Aleixgelabert/TFM/README.md

# TFM
Treball Final del Màster de Mecatrònica
