Aleixgelabert/TFM/SOFTWARE/LOGS/Log_ESP32_NO_OK.rtf

I (15945) ESP32: Rx_COM: SEQ_COM=0 RX_COM=504 LOST_COM=0 LOSS_COM=0.00%
I (15945) ESP32: vx: 0.0 vy: 0.0 BTN=0
I (15975) ESP32: Rx_COM: SEQ_COM=0 RX_COM=505 LOST_COM=0 LOSS_COM=0.00%
I (15975) ESP32: vx: 0.0 vy: 0.0 BTN=0
I (15995) ESP32: Rx_COM: SEQ_COM=0 RX_COM=506 LOST_COM=0 LOSS_COM=0.00%
I (15995) ESP32: vx: 0.0 vy: 0.0 BTN=0
I (16025) ESP32: Rx_COM: SEQ_COM=0 RX_COM=507 LOST_COM=0 LOSS_COM=0.00%
I (16025) ESP32: vx: 0.0 vy: 0.0 BTN=0
I (16055) ESP32: Rx_COM: SEQ_COM=0 RX_COM=508 LOST_COM=0 LOSS_COM=0.00%
I (16055) ESP32: vx: 0.0 vy: 0.0 BTN=0
I (16075) ESP32: Rx_COM: SEQ_COM=0 RX_COM=509 LOST_COM=0 LOSS_COM=0.00%
I (16075) ESP32: vx: 0.0 vy: 0.0 BTN=0
I (16115) ESP32: Rx_COM: SEQ_COM=0 RX_COM=510 LOST_COM=0 LOSS_COM=0.00%
I (16115) ESP32: vx: 0.0 vy: 0.0 BTN=0
I (16125) ESP32: Rx_COM: SEQ_COM=0 RX_COM=511 LOST_COM=0 LOSS_COM=0.00%
I (16125) ESP32: vx: 0.0 vy: 0.0 BTN=0
I (16145) ESP32: Rx_COM: SEQ_COM=0 RX_COM=512 LOST_COM=0 LOSS_COM=0.00%
I (16145) ESP32: vx: 0.0 vy: 0.0 BTN=0
I (16175) ESP32: Rx_COM: SEQ_COM=0 RX_COM=513 LOST_COM=0 LOSS_COM=0.00%
I (16175) ESP32: vx: 0.0 vy: 0.0 BTN=0
I (16205) ESP32: Rx_COM: SEQ_COM=0 RX_COM=514 LOST_COM=0 LOSS_COM=0.00%
I (16205) ESP32: vx: 0.0 vy: 0.0 BTN=0
I (16225) ESP32: Rx_COM: SEQ_COM=0 RX_COM=515 LOST_COM=0 LOSS_COM=0.00%
I (16225) ESP32: vx: 0.0 vy: 0.0 BTN=0
I (16245) ESP32: Rx_COM: SEQ_COM=0 RX_COM=516 LOST_COM=0 LOSS_COM=0.00%
I (16245) ESP32: vx: 0.0 vy: 0.0 BTN=0
I (16275) ESP32: Tx_ESP: SEQ_ESP=31 TX_ESP=31
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
I (27955) ESP32: vx: 90.0 vy: 90.0 BTN=0
I (27985) ESP32: Rx_COM: SEQ_COM=37166 RX_COM=995 LOST_COM=36841 LOSS_COM=97.37%
I (27985) ESP32: vx: 90.0 vy: 90.0 BTN=0
I (28005) ESP32: Rx_COM: SEQ_COM=37167 RX_COM=996 LOST_COM=36841 LOSS_COM=97.37%
I (28005) ESP32: vx: 90.0 vy: 90.0 BTN=0
I (28035) ESP32: Rx_COM: SEQ_COM=37168 RX_COM=997 LOST_COM=36841 LOSS_COM=97.37%
I (28035) ESP32: vx: 90.0 vy: 90.0 BTN=0
I (28055) ESP32: Rx_COM: SEQ_COM=37169 RX_COM=998 LOST_COM=36841 LOSS_COM=97.36%
I (28065) ESP32: vx: 90.0 vy: 90.0 BTN=0
I (28075) ESP32: Rx_COM: SEQ_COM=37170 RX_COM=999 LOST_COM=36841 LOSS_COM=97.36%
I (28075) ESP32: vx: 90.0 vy: 90.0 BTN=0
I (28105) ESP32: Rx_COM: SEQ_COM=37171 RX_COM=1000 LOST_COM=36841 LOSS_COM=97.36%
I (28105) ESP32: vx: 90.0 vy: 90.0 BTN=0
I (28145) ESP32: Rx_COM: SEQ_COM=37172 RX_COM=1001 LOST_COM=36841 LOSS_COM=97.35%
I (28145) ESP32: vx: 90.0 vy: 90.0 BTN=0
I (28155) ESP32: Rx_COM: SEQ_COM=37173 RX_COM=1002 LOST_COM=36841 LOSS_COM=97.35%
I (28155) ES--- Error: read failed: [Errno 6] Device not configured
--- Waiting for the device to reconnect..............
