Aleixgelabert/TFM/SOFTWARE/LOGS/LOG_ESP32_OK.rtf

I (5445) ESP32: Rx_COM: SEQ_COM=63598 RX_COM=108 LOST_COM=0 LOSS_COM=0.00%
I (5445) ESP32: vx: 180.0 vy: 90.0 BTN=1
I (5475) ESP32: Rx_COM: SEQ_COM=63599 RX_COM=109 LOST_COM=0 LOSS_COM=0.00%
I (5475) ESP32: vx: 180.0 vy: 90.0 BTN=1
I (5495) ESP32: Rx_COM: SEQ_COM=63600 RX_COM=110 LOST_COM=0 LOSS_COM=0.00%
I (5495) ESP32: vx: 180.0 vy: 90.0 BTN=1
I (5515) ESP32: Rx_COM: SEQ_COM=63601 RX_COM=111 LOST_COM=0 LOSS_COM=0.00%
I (5515) ESP32: vx: 180.0 vy: 90.0 BTN=1
I (5535) ESP32: Rx_COM: SEQ_COM=63602 RX_COM=112 LOST_COM=0 LOSS_COM=0.00%
I (5545) ESP32: vx: 180.0 vy: 90.0 BTN=1
I (5565) ESP32: Rx_COM: SEQ_COM=63603 RX_COM=113 LOST_COM=0 LOSS_COM=0.00%
I (5565) ESP32: vx: 180.0 vy: 90.0 BTN=1
I (5585) ESP32: Rx_COM: SEQ_COM=63604 RX_COM=114 LOST_COM=0 LOSS_COM=0.00%
I (5595) ESP32: vx: 180.0 vy: 90.0 BTN=1
I (5615) ESP32: Rx_COM: SEQ_COM=63605 RX_COM=115 LOST_COM=0 LOSS_COM=0.00%
I (5615) ESP32: vx: 180.0 vy: 90.0 BTN=1
I (5635) ESP32: Rx_COM: SEQ_COM=63606 RX_COM=116 LOST_COM=0 LOSS_COM=0.00%
I (5645) ESP32: vx: 180.0 vy: 90.0 BTN=1
I (5665) ESP32: Rx_COM: SEQ_COM=63607 RX_COM=117 LOST_COM=0 LOSS_COM=0.00%
I (5665) ESP32: vx: 180.0 vy: 90.0 BTN=1
I (5685) ESP32: Rx_COM: SEQ_COM=63608 RX_COM=118 LOST_COM=0 LOSS_COM=0.00%
I (5695) ESP32: vx: 180.0 vy: 90.0 BTN=1
I (5715) ESP32: Rx_COM: SEQ_COM=63609 RX_COM=119 LOST_COM=0 LOSS_COM=0.00%
I (5715) ESP32: vx: 180.0 vy: 90.0 BTN=1
I (5735) ESP32: Rx_COM: SEQ_COM=63610 RX_COM=120 LOST_COM=0 LOSS_COM=0.00%
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
