Aleixgelabert/TFM/HARDWARE/COMANDAMENT/MICROCONTROLADORS/ESP32/Micropython/PROVES MAIN/ILI9488b.py.html

Skip to content

## Navigation Menu

# Global navigation

Loading

© 2025 GitHub, Inc.

About (https://github.com/about) Blog (https://github.blog) Terms (https://docs.github.com/site-policy/github-terms/github-terms-of-service) Privacy (https://docs.github.com/site-policy/privacy-policies/github-privacy-statement) Security (https://github.com/security) Status (https://www.githubstatus.com/)

### Uh oh!

There was an error while loading. Please reload this page.

(https://github.com/)

Type / to search

# Search code, repositories, users, issues, pull requests...

Search

Clear

Search syntax tips (https://docs.github.com/search-github/github-code-search/understanding-github-code-search-syntax)

Give feedback

# Provide feedback

We read every piece of feedback, and take your input very seriously.

Include my email address so I can be contacted

Cancel Submit feedback

# Saved searches

## Use saved searches to filter your results more quickly

Name

Query

To see all available qualifiers, see our documentation (https://docs.github.com/search-github/github-code-search/understanding-github-code-search-syntax).

Cancel Create saved search

Chat with Copilot

Open Copilot…

Create new… Your issues Your pull requests

Notifications



### Uh oh!

There was an error while loading. Please reload this page.

Dismiss alert

Open in github.dev Open in a new github.dev tab Open in codespace

## FilesCollapse file tree

## Files

main

Add fileSearch this repository

t

/

# ILI9488b.py

Copy path

BlameMore file actions

BlameMore file actions

## Latest commit

## History

History

217 lines (177 loc) · 7.99 KB

/

# ILI9488b.py

Top

## File metadata and controls

- Code
- Blame

217 lines (177 loc) · 7.99 KB

Raw (https://github.com/L3pu5/ILI9488_micropython/raw/refs/heads/main/ILI9488b.py)

Copy raw file

Download raw file

(https://github.dev/) (https://github.dev/)

Fork this repository and edit the file

More edit options

Open symbols panel

Edit and raw actions

1

2

3

4

5

6

7

8

9

10

11

12

13

14

15

16

17

18

19

20

21

22

23

24

25

26

27

28

29

30

31

32

33

34

35

36

37

38

39

40

41

42

43

44

45

46

47

48

49

50

51

52

53

54

55

56

57

58

59

60

61

62

63

64

65

66

67

68

69

70

71

72

73

74

75

76

77

78

79

80

81

82

83

84

85

86

87

88

89

90

91

92

93

94

95

96

97

98

99

100

101

102

103

104

105

106

107

108

109

110

111

112

113

114

115

116

117

118

119

120

121

122

123

124

125

126

127

128

129

130

131

132

133

134

135

136

137

138

139

140

141

142

143

144

145

146

147

148

149

150

151

152

153

154

155

156

157

158

159

160

161

162

163

164

165

166

167

168

169

170

171

172

173

174

175

176

177

178

179

180

181

182

183

184

185

186

187

188

189

190

191

192

193

194

195

196

197

198

199

200

201

202

203

204

205

206

207

208

209

210

211

212

213

214

215

216

# ILI4988b.

# By L3pu5, L3pu5_Hare

# A simple Python wrapper for the ILI4988 driver bound to the SPI interface IM[2:0] 101 for chipsets such as

# those ubuqituous ones on Aliexpress.

from c565_chunk.c565_chunk import c565_chunk_image, c565_chunk

from bnuuyDrivers_micropython.RECTANGLE import RECTANGLE

from time import sleep

from math import floor

import ustruct

PICO_EXPERIMENTAL_MAX_BUFFER = 60_000 #Bytes, give/take memory. (42512 with earlier verison of this build)

# Ihave gotten this to 60_000?

#565 RGBcolour 2 byte datastructure

def color565(r,g,b):

return (r & 0xf8) << 8 | (g & 0xfc) << 3 | b >> 3

class Display():

#Initialised Register values are defined on 13.1 pg. 306

# Mostly : Sleep IN, Display OFF, Idle OFF, All Pixels OFF, Col_End 0x013F Row_End 0x01DF

# : Color_pixel_format 18Bit/Pix

# Command constants from ILI9488 datasheet (Limited)

# * Can be used in short Packet (no param)

# ** Can be used in short Packet (1 param)

# WRITE - NO PARAM Note Ref

NO_OP = const(0x00) # No Operation * 5.2.1

SOFT_RESET = const(0x01) # Software Reset * 5.2.2

SLEEP_IN = const(0x10) # Enter Sleep * 5.2.12

SLEEP_OUT = const(0x11) # Leave Sleep * 5.2.13

## ??

PIXELS_ALL_OFF = const(0x22) # Turn all pixels off 5.2.18

PIXELS_ALL_ON = const(0x23) # Turn all pixels on 5.2.19

## CONFIGURATION?

PIXELS_FORMAT = const(0x3A) # Colour format 5.2.34 DBI[2:0], DPI[2:0] -> 101 for 565 --> b'01010101'

CONFIG_BUFFER = const(0x36) # Buffer configuration 5.2.30

DISPLAY_FUNC = const(0xB6) # Display Op Mode 5.3.7

## OPERATIONAL MODES

MODE_PARTIAL = const(0x12) # Enter Partial * 5.2.14 (Described in 0x30, )

MODE_NORMAL = const(0x13) # Enter Normal * 5.2.15 (Disables Scroll/partial mode)

## DISPLAY MODES

DISPLAY_OFF = const(0x28) # Turn Display off * 5.2.20 (Screen still lit, memory not drawn)

DISPLAY_ON = const(0x29) # Turn Display on * 5.2.21

## IDLE MODES

IDLE_ON = const(0x39) # Enter Idle * 5.2.33 (Nukes colour density to save power)

IDLE_OFF = const(0x38) # Leave Idle * 5.2.32 (Full colour density)

ADDR_SET_COL = const(0x2A) # Set Col *

ADDR_SET_ROW = const(0x2B) # Set Row/Page *

WRITE_MEM = const(0x2C) # Write Memory * 5.2.24

FRAME_RATE = const(0xB1) # 5.3.2

CABC_9 = const(0xCF) # 5.3.26

#CABC_9 is the only needed CABC control.

def __init__(self, spi, cs, dc, rst, width, height):

#CS, DC are of type PIN()

#CS pin means the chip is selected and data is going to be sent over the serial bus

#DC means data/command -> if low, command, if high parameter.

self.spi = spi

self.cs = cs

self.dc = dc

self.reset = rst

self.width = width

self.height = height

self.buffer = b""

#Set default pin values

self.cs.init(self.cs.OUT, value=1)

self.dc.init(self.dc.OUT, value=0)

self.reset.init(self.reset.OUT, value=1)

cs.value(1)

dc.value(0)

rst.value(1)

self.minimum_board_init()

self.minimum_configuration()

#self.build_buffer()

self.clear()

def build_buffer(self):

#Do some controls here to see if we can save memory, or afford the buffer

self.buffer = color565(0,0,0).to_bytes(2, "big") * self.width * self.height

def minimum_board_init(self):

#Send the reset command to the display screen

self.full_reset()

sleep(.2)

#Awake

self.write_command(self.SLEEP_OUT)

sleep(.1)

#???

self.write_command(self.CABC_9, 0x10)

#Screen ON

self.write_command(self.DISPLAY_ON)

#CABC_9 is the ONLY required field.

def minimum_configuration(self):

#Set Pixel format

self.write_command(self.PIXELS_FORMAT, int(b'01010101', 2))

#Orientation

self.write_command(self.CONFIG_BUFFER, int(b"01101000",2))

def clear(self):

self.write_buffer(0,0, self.width, self.height, self.buffer)

def full_reset(self):

#Reset the buffers on the display board

self.write_command(self.SOFT_RESET)

#ALlow device to do the reset

sleep(.2)

def reset_display(self):

self.reset(1)

sleep(0.05)

self.reset(0)

sleep(0.05)

#Drawing Functions

# Draw Buffer

def write_buffer(self, rect, buffer):

self.write_buffer(rect.x, rect.y, rect.width, rect.height, buffer)

def write_buffer(self, x, y, width, height, buffer):

self.write_command(self.ADDR_SET_ROW, *ustruct.pack(">HH", x, x+width-1))

self.write_command(self.ADDR_SET_COL, *ustruct.pack(">HH", y, y+height-1))

self.write_command(self.WRITE_MEM)

self.write_data(buffer)

# Draw c565 Chunk

def draw_c565_chunk(self, chunk: c565_chunk):

self.write_buffer(chunk.get_image_x(), chunk.get_image_y(), chunk.width, chunk.height, chunk.buffer)

print(chunk)

# Draw Buffer -> Draw c565 Image

def draw_c565_image(self, path):

image = c565_chunk_image()

image.read_from_image_file(path)

image.iterate_with_c565chunks( lambda chunk: self.draw_c565_chunk(chunk))

#Dispose of the image

del image

# Draw Pixel

def draw_pixel(self, x, y, colour):

self.write_buffer(x, y, 0, 0, colour.to_bytes(2, 'big'))

# Draw Rect

def fill_rectangle(self, rect, color):

buffer = color.to_bytes(2, "big") * rect.width * rect.height

self.write_buffer(rect.x, rect.y, rect.width, rect.height, buffer)

#Drawing Troubleshooting functions

def test_single_range(self, cmd, min, max, step, deltaTime, color=0x00):

for i in range(min, max, step):

self.write_command(cmd, i)

self.draw_horizontal_range_bar(0, self.height-20, self.width, 20,(i-min)/max, color)

sleep(deltaTime)

self.write_command(cmd, min)

def test_single_range_custom_bar(self, cmd, min, max, step, deltaTime, custom_bar, color=0x00):

if(custom_bar.width > custom_bar.height):

for i in range(min, max, step):

self.write_command(cmd, i)

self.draw_horizontal_range_bar(custom_bar,(i-min)/(max), color)

sleep(deltaTime)

else:

for i in range(min, max, step):

self.write_command(cmd, i)

self.draw_vertical_range_bar(custom_bar, (i-min)/(max) ,color)

sleep(deltaTime)

self.write_command(cmd, min)

#A horizontal bar starting at x,y growing to x+width, y+height,

def draw_horizontal_range_bar(self, rect, progress, color=0x00):

trueWidth = floor((rect.width)*progress)

intermediate = RECTANGLE.from_dimensions(rect.x,rect.y,trueWidth, rect.height)

self.fill_rectangle(intermediate, color)

#A vertical bar starting at x,y growing to x+width, y+height

def draw_vertical_range_bar(self, rect, progress, color=0x00):

trueHeight = floor((rect.height)*progress)

intermediate = RECTANGLE.from_dimensions(rect.x,rect.y,rect.width, trueHeight)

print(intermediate)

self.fill_rectangle(intermediate, color)

# IO

# Data Functions

def write_data(self, buffer):

self.dc(1)

self.cs(0)

self.spi.write(buffer)

self.cs(1)

def write_command(self, cmd, *opt_args):

# Set DC = 0 for Data, set CS to 0

self.dc(0)

self.cs(0)

self.spi.write(bytearray([cmd]))

self.cs(1)

if len(opt_args) > 0:

self.write_data(bytearray(opt_args))

## Footer

(https://github.com) © 2025 GitHub, Inc.

You can’t perform that action at this time.
