Aleixgelabert/TFM/DOCS/aft-view-of-SKORPIOS-by-Nautors-Swan-665x443.jpg

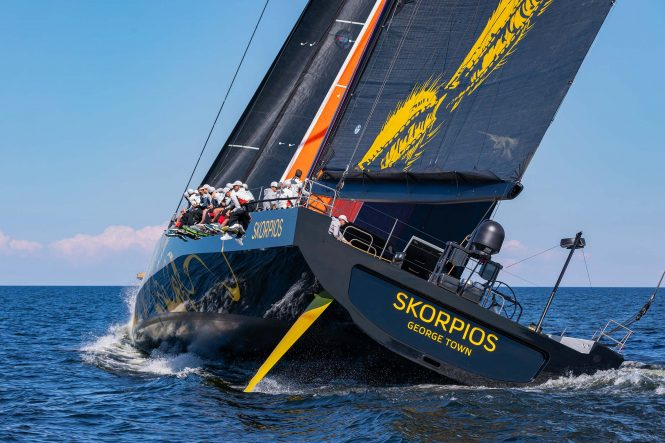
DOCS/aft-view-of-SKORPIOS-by-Nautors-Swan-665x443.jpg
