Aleixgelabert/TFM/DOCS/IMATGES/BATERIA_RTC.png

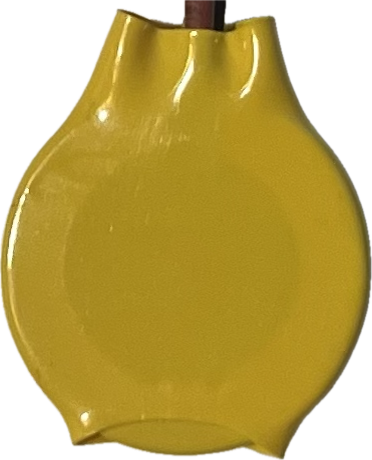
DOCS/IMATGES/BATERIA_RTC.png
