Aleixgelabert/TFM/DOCS/IMATGES/BOTONERA_CARIBONI.jpg

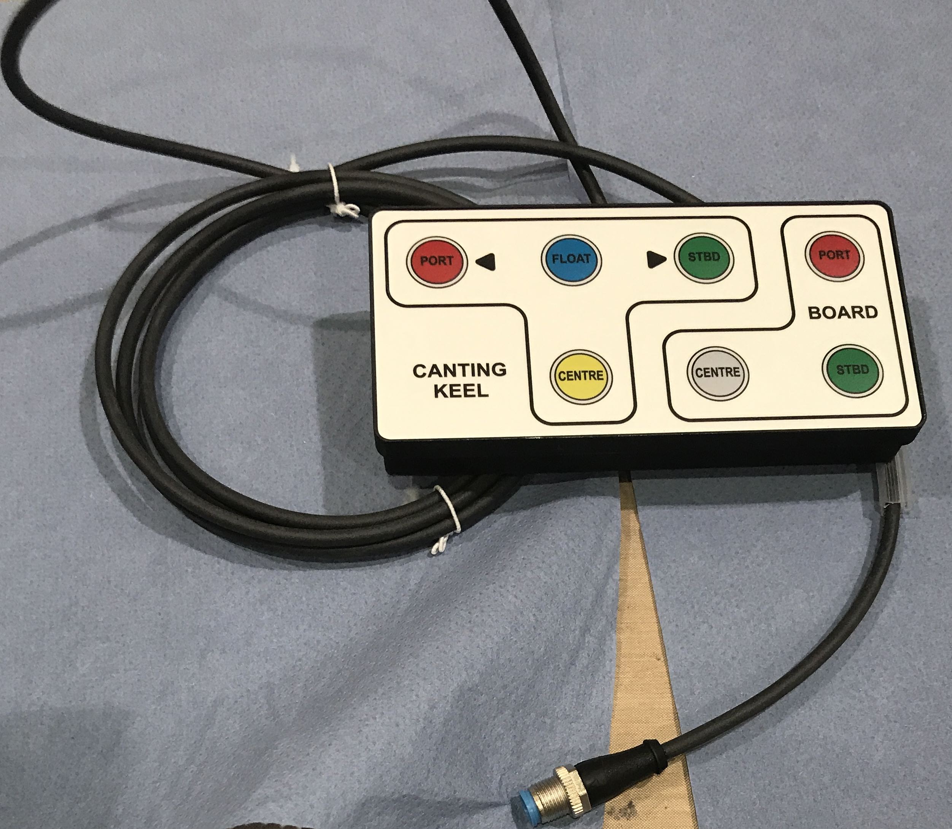
DOCS/IMATGES/BOTONERA_CARIBONI.jpg
