Aleixgelabert/TFM/DOCS/IMATGES/Diode.png

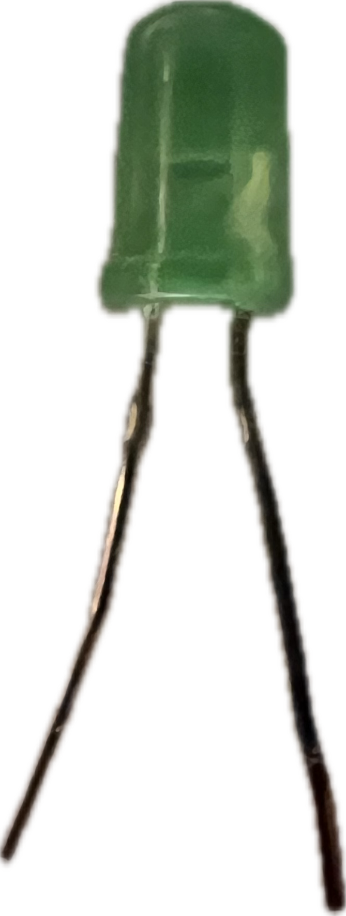
DOCS/IMATGES/Diode.png
