Aleixgelabert/TFM/DOCS/IMATGES/Diode_RGB.png

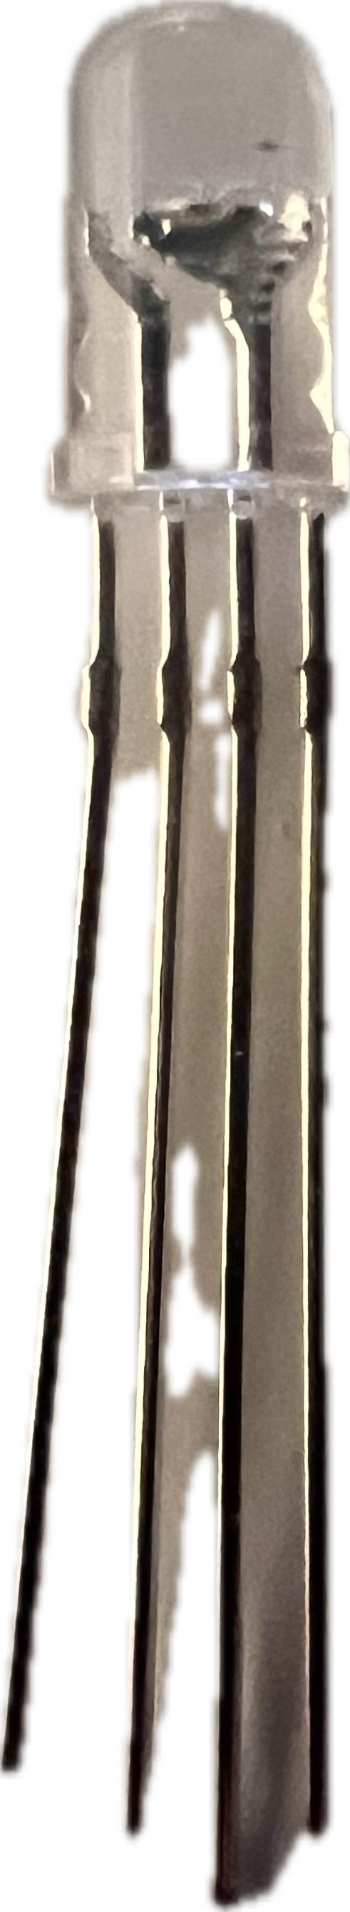
DOCS/IMATGES/Diode_RGB.png
