Aleixgelabert/TFM/DOCS/IMATGES/Esquema_1.jpg

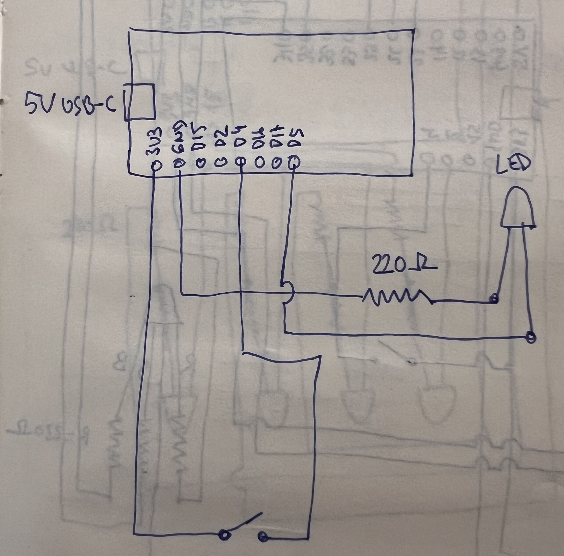
DOCS/IMATGES/Esquema_1.jpg
