Aleixgelabert/TFM/DOCS/IMATGES/Esquema_2.jpg

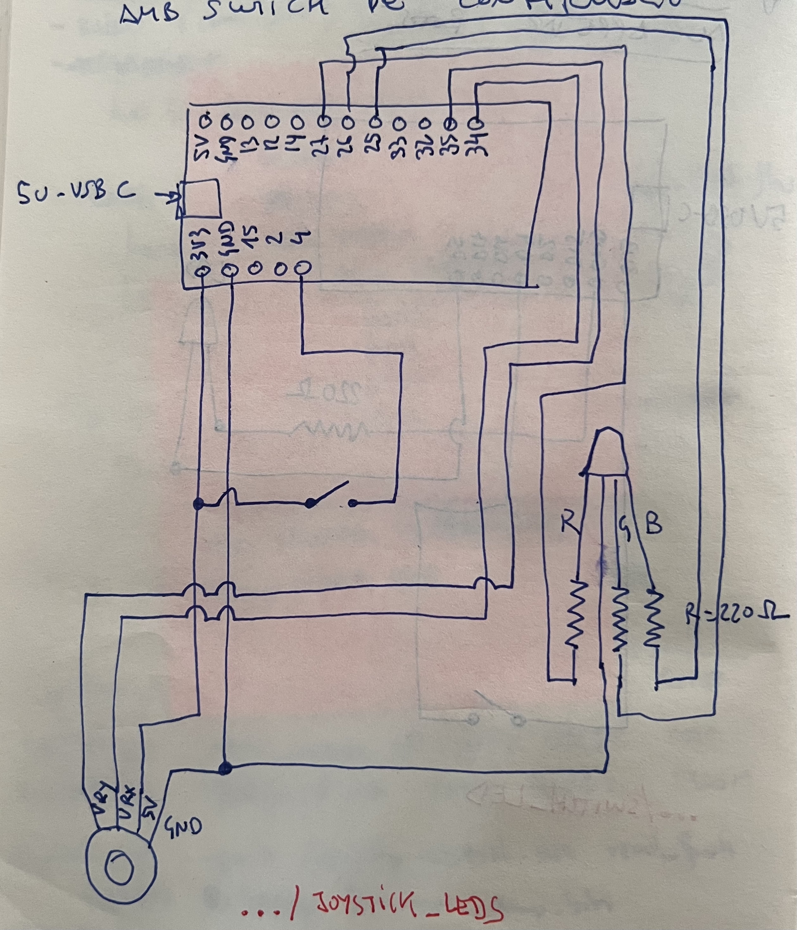
DOCS/IMATGES/Esquema_2.jpg
