Aleixgelabert/TFM/DOCS/IMATGES/Esquema_3.jpg

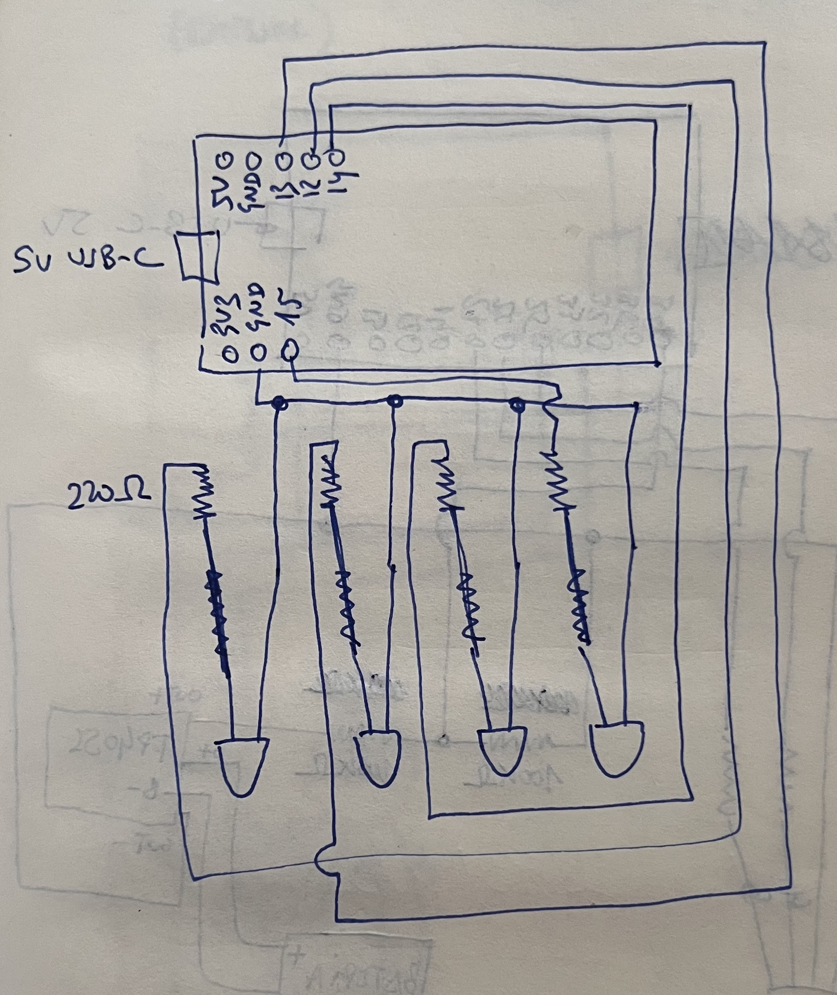
DOCS/IMATGES/Esquema_3.jpg
