Aleixgelabert/TFM/DOCS/IMATGES/Esquema_4.jpg

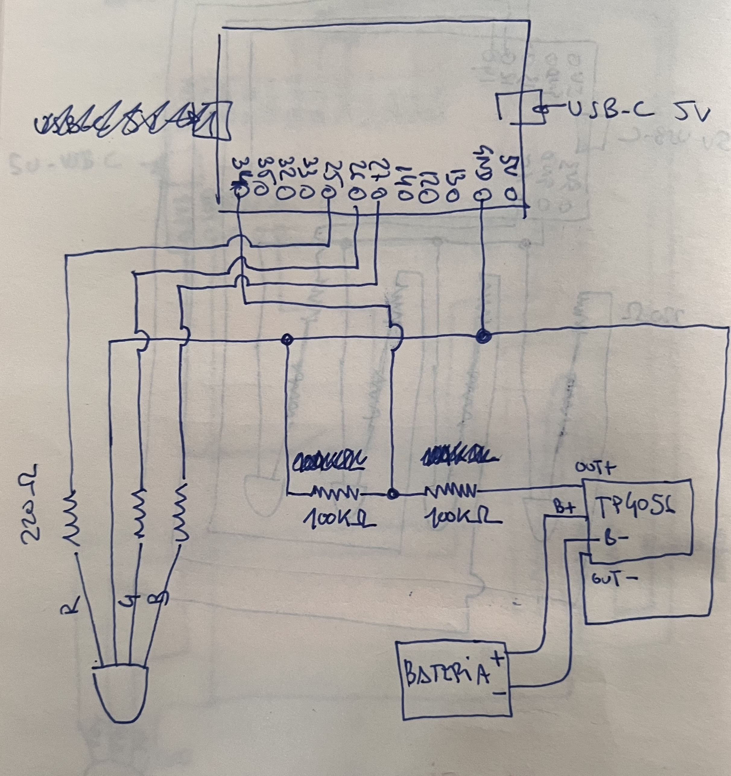
DOCS/IMATGES/Esquema_4.jpg
