Aleixgelabert/TFM/DOCS/IMATGES/Esquema_5.jpg

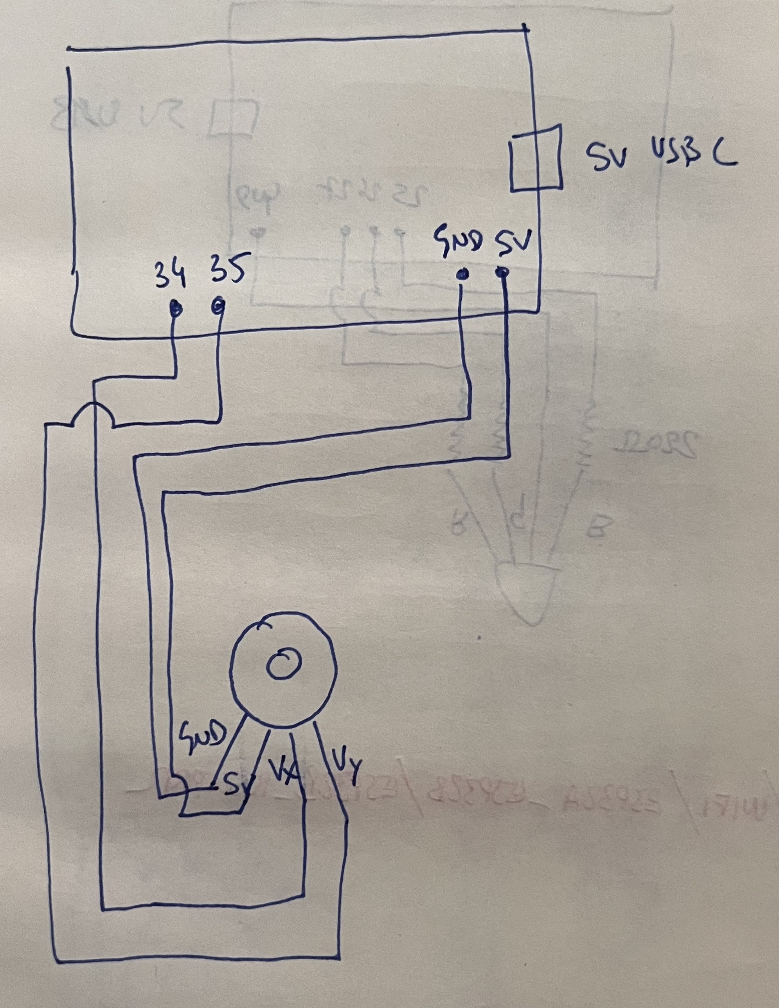
DOCS/IMATGES/Esquema_5.jpg
