Aleixgelabert/TFM/DOCS/IMATGES/Esquema_6.jpg

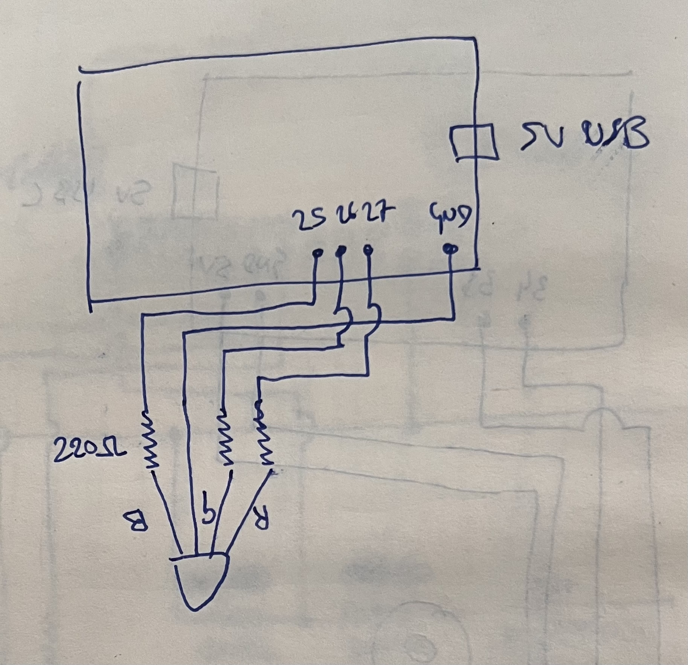
DOCS/IMATGES/Esquema_6.jpg
