Aleixgelabert/TFM/DOCS/IMATGES/Esquema_7.jpg

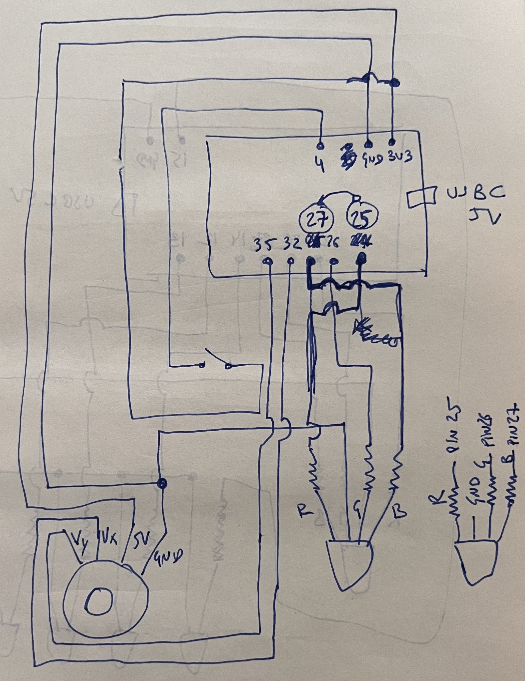
DOCS/IMATGES/Esquema_7.jpg
