Aleixgelabert/TFM/DOCS/IMATGES/Esquema_8.jpg

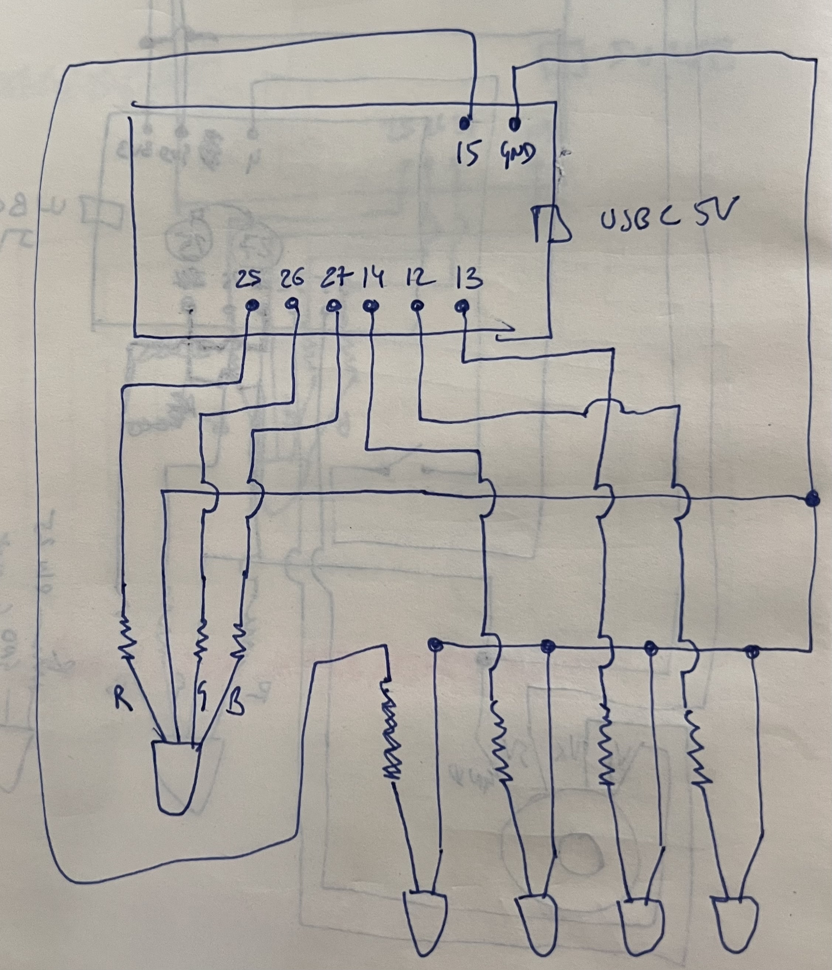
DOCS/IMATGES/Esquema_8.jpg
