Aleixgelabert/TFM/DOCS/IMATGES/Esquema_9.jpg

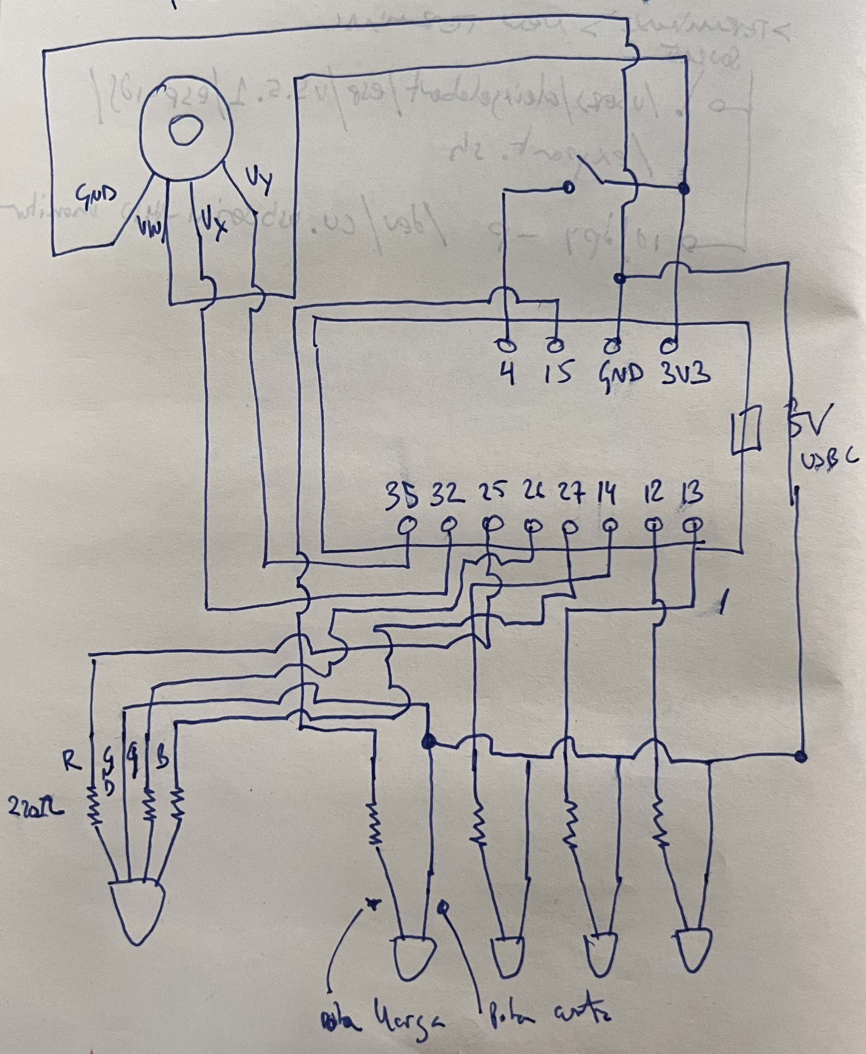
DOCS/IMATGES/Esquema_9.jpg
