Aleixgelabert/TFM/DOCS/IMATGES/Esquema_10.jpg

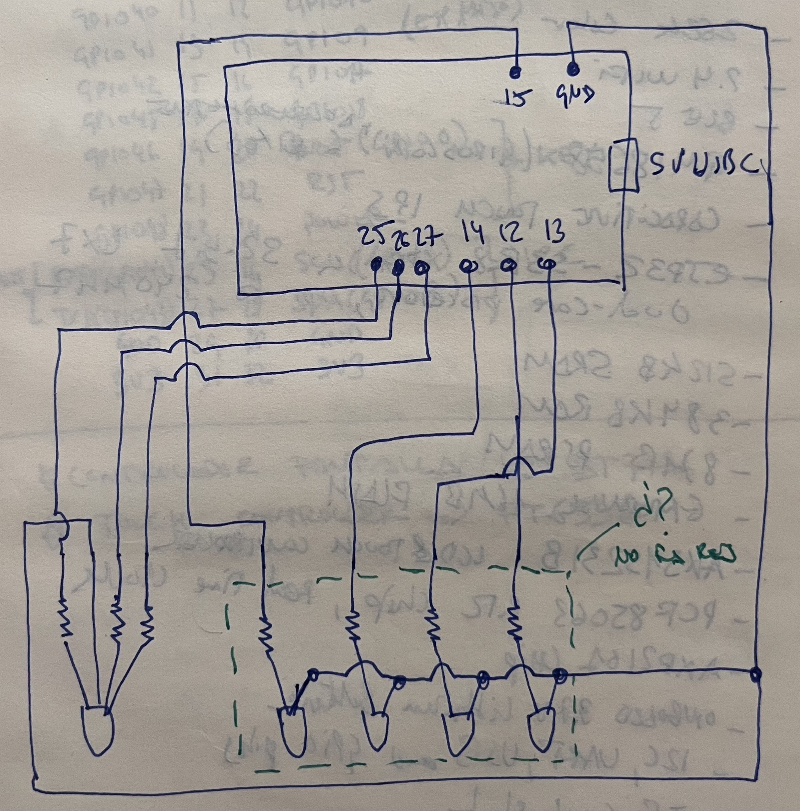
DOCS/IMATGES/Esquema_10.jpg
