Aleixgelabert/TFM/DOCS/IMATGES/Esquema_11.jpg

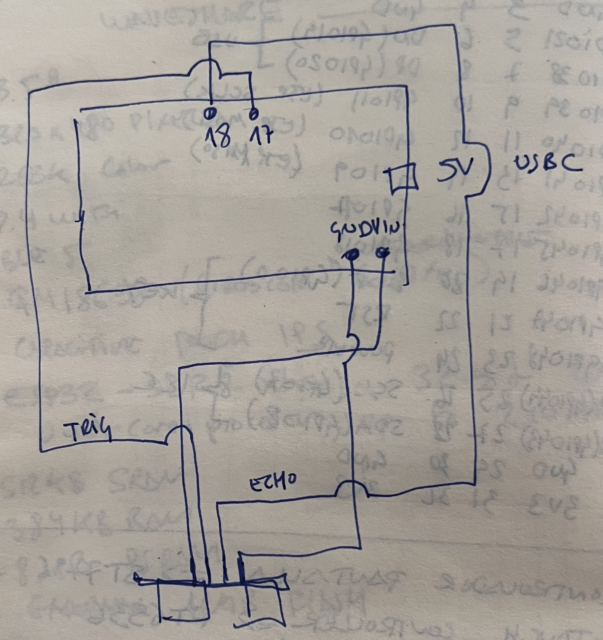
DOCS/IMATGES/Esquema_11.jpg
