Aleixgelabert/TFM/DOCS/IMATGES/Esquema_12.jpg

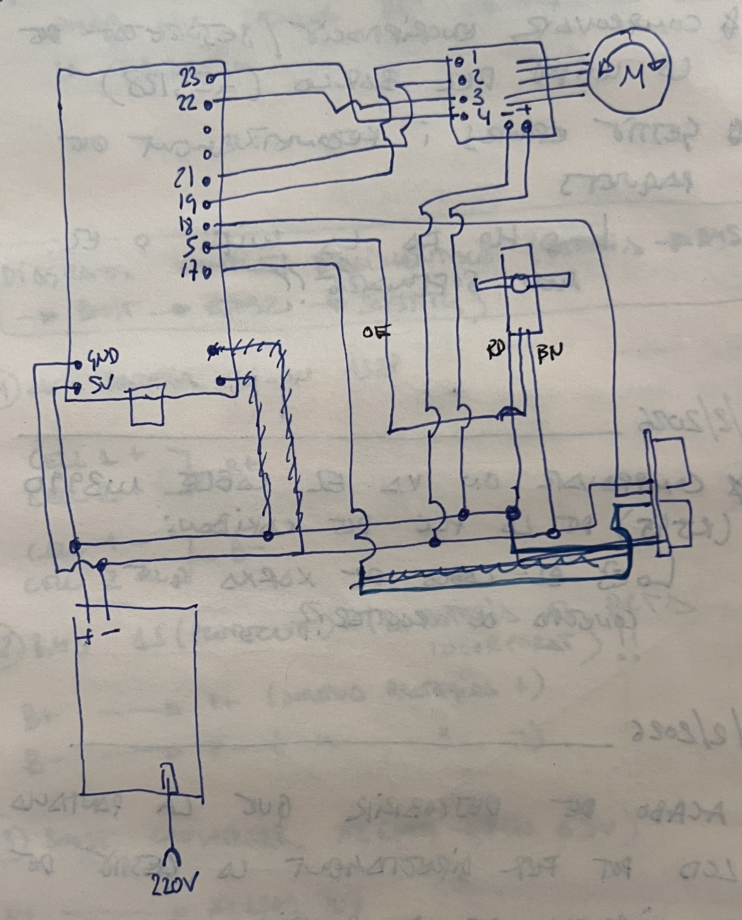
DOCS/IMATGES/Esquema_12.jpg
