Aleixgelabert/TFM/DOCS/IMATGES/JOYSTICK_SERIES_68B.png

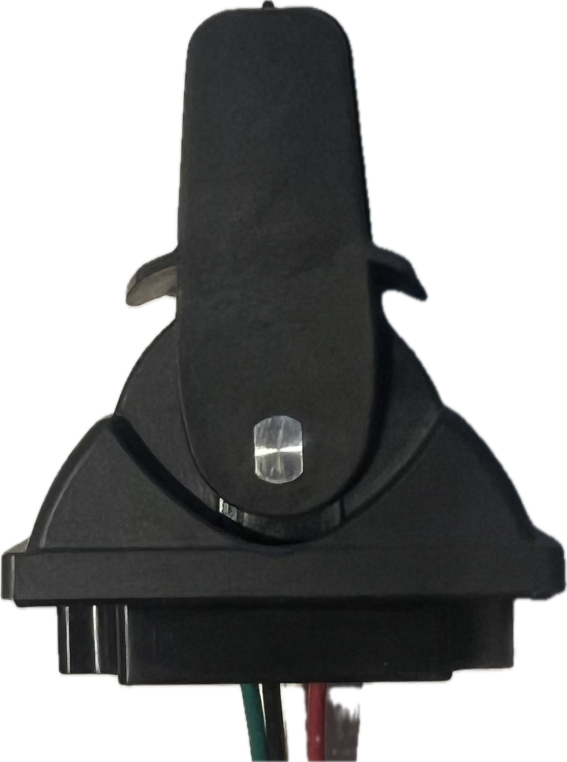
DOCS/IMATGES/JOYSTICK_SERIES_68B.png
