Aleixgelabert/TFM/DOCS/IMATGES/Model_Simulacio.png

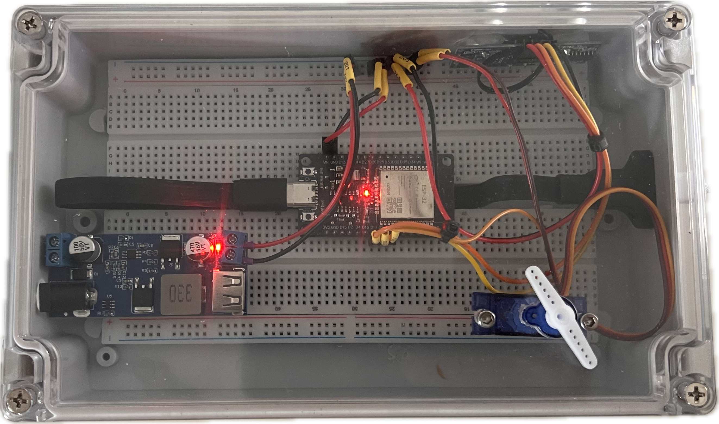
DOCS/IMATGES/Model_Simulacio.png
