Aleixgelabert/TFM/DOCS/IMATGES/Resistència.jpg

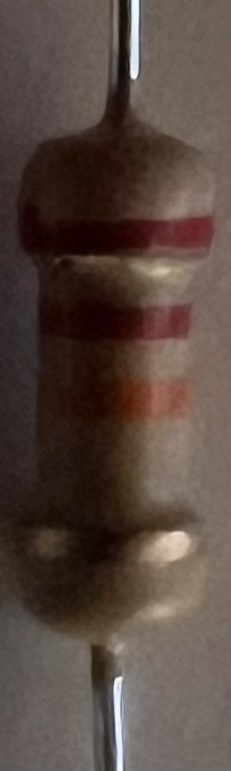
DOCS/IMATGES/Resistència.jpg
