Aleixgelabert/TFM/DOCS/IMATGES/Stepper.png

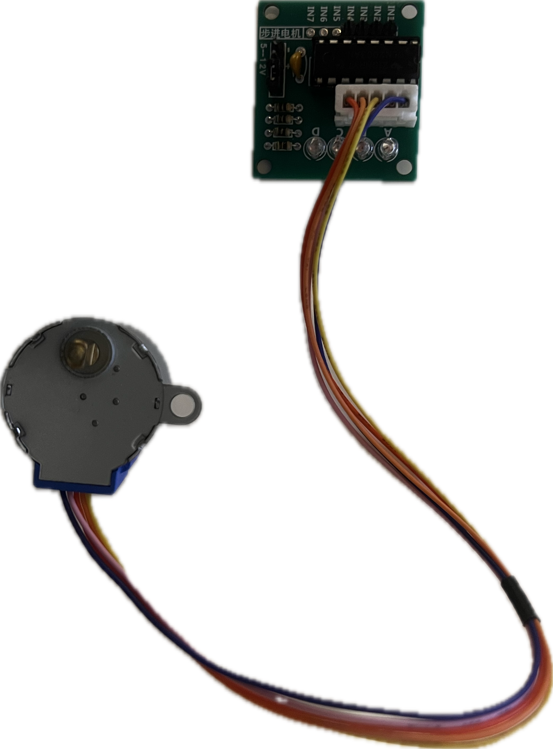
DOCS/IMATGES/Stepper.png
