Aleixgelabert/TFM/DOCS/IMATGES/STEPPER_MOTOR.png

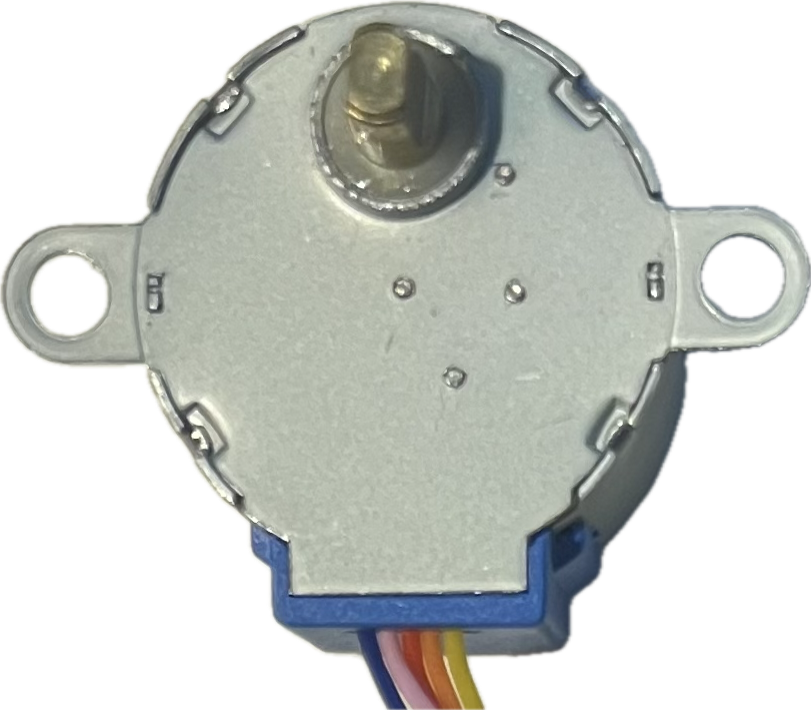
DOCS/IMATGES/STEPPER_MOTOR.png
