Aleixgelabert/TFM/DOCS/IMATGES/TP4056.png

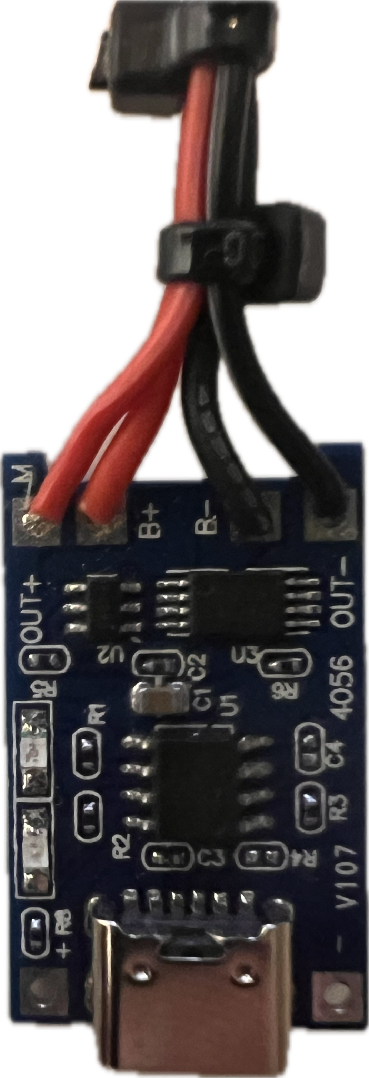
DOCS/IMATGES/TP4056.png
