Aleixgelabert/TFM/HARDWARE/EXISTENT SKORPIOS/SOFTWARE/PLC Twincat/BIN/VISU_BACKGROUND.bmp

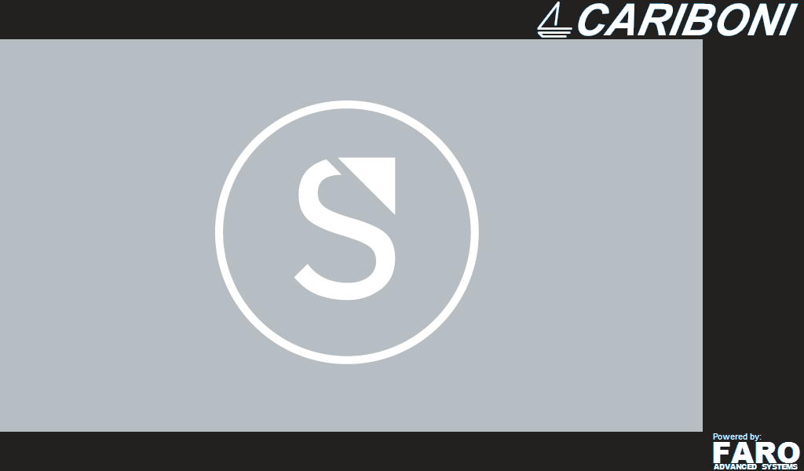
HARDWARE/EXISTENT SKORPIOS/SOFTWARE/PLC Twincat/BIN/VISU_BACKGROUND.bmp
