Aleixgelabert/TFM/HARDWARE/EXISTENT SKORPIOS/SOFTWARE/PLC Twincat/BIN/VISU_BOARD.bmp

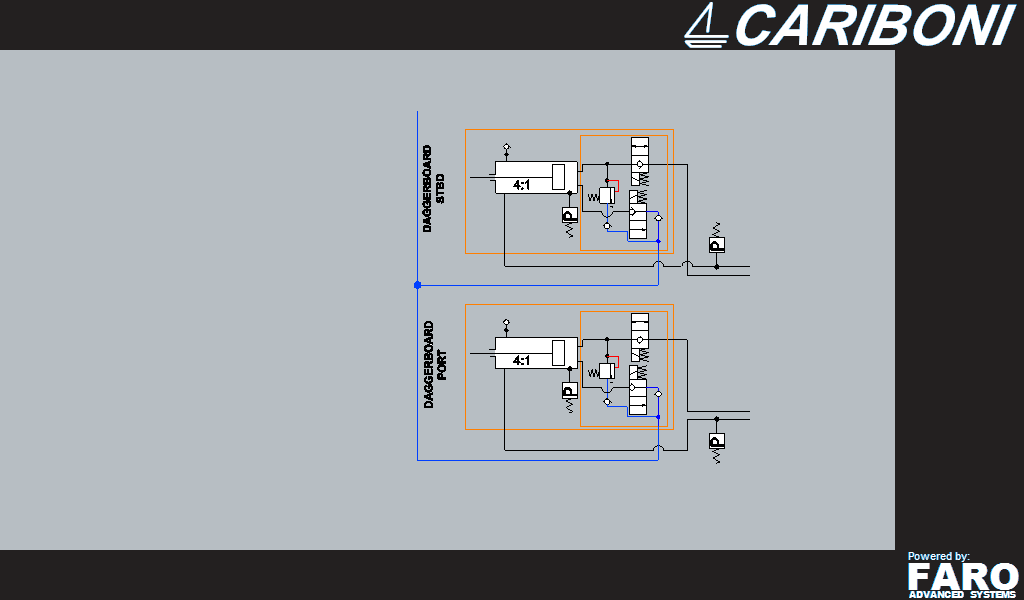
HARDWARE/EXISTENT SKORPIOS/SOFTWARE/PLC Twincat/BIN/VISU_BOARD.bmp
