Aleixgelabert/TFM/HARDWARE/EXISTENT SKORPIOS/SOFTWARE/PLC Twincat/BIN/VISU_HOME.bmp

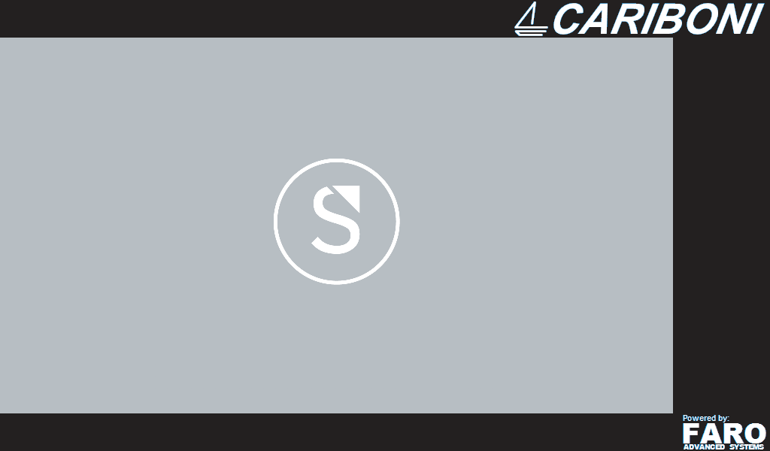
HARDWARE/EXISTENT SKORPIOS/SOFTWARE/PLC Twincat/BIN/VISU_HOME.bmp
