Aleixgelabert/TFM/HARDWARE/EXISTENT SKORPIOS/SOFTWARE/PLC Twincat/BIN/VISU_KEEL.bmp

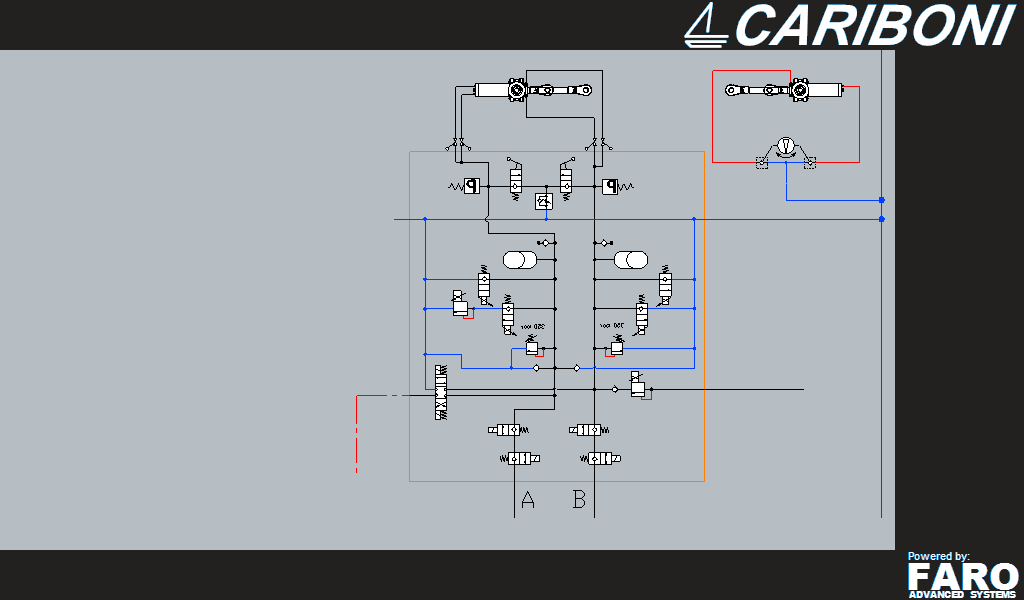
HARDWARE/EXISTENT SKORPIOS/SOFTWARE/PLC Twincat/BIN/VISU_KEEL.bmp
