Aleixgelabert/TFM/HARDWARE/EXISTENT SKORPIOS/SOFTWARE/PLC Twincat/BIN/VISU_PUMPS.bmp

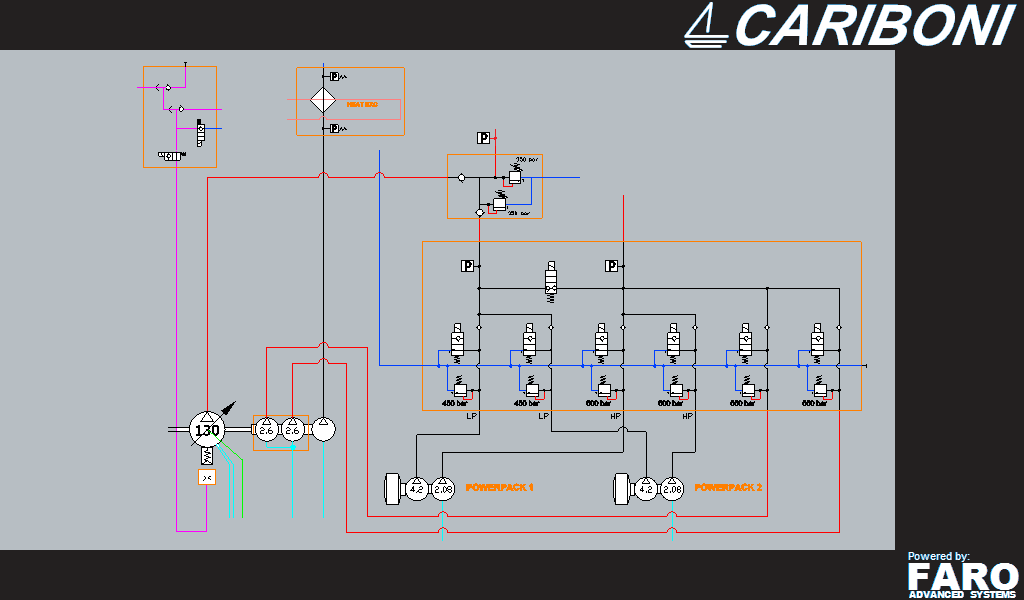
HARDWARE/EXISTENT SKORPIOS/SOFTWARE/PLC Twincat/BIN/VISU_PUMPS.bmp
