Aleixgelabert/TFM/HARDWARE/EXISTENT SKORPIOS/SOFTWARE/PLC Twincat/screensaver.bmp

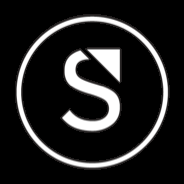
HARDWARE/EXISTENT SKORPIOS/SOFTWARE/PLC Twincat/screensaver.bmp
