Aleixgelabert/TFM/HARDWARE/EXISTENT SKORPIOS/SOFTWARE/PLC Twincat/unnamed.png

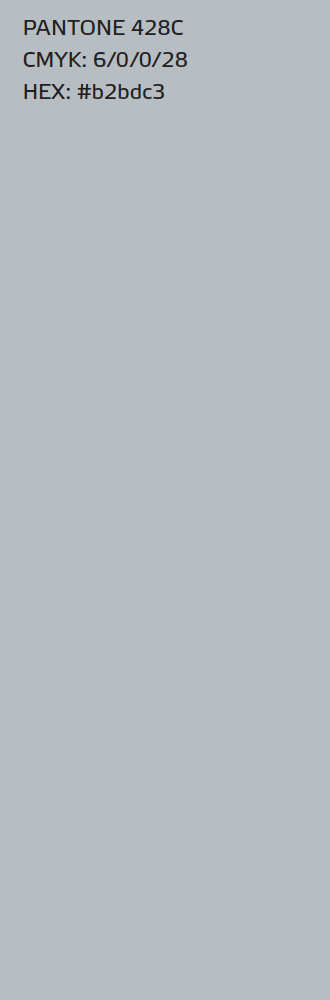
HARDWARE/EXISTENT SKORPIOS/SOFTWARE/PLC Twincat/unnamed.png
