Aleixgelabert/TFM/HARDWARE/JOYSTICKS/GRAYHILL_SERIES_68B/68b-drawing-01.jpg

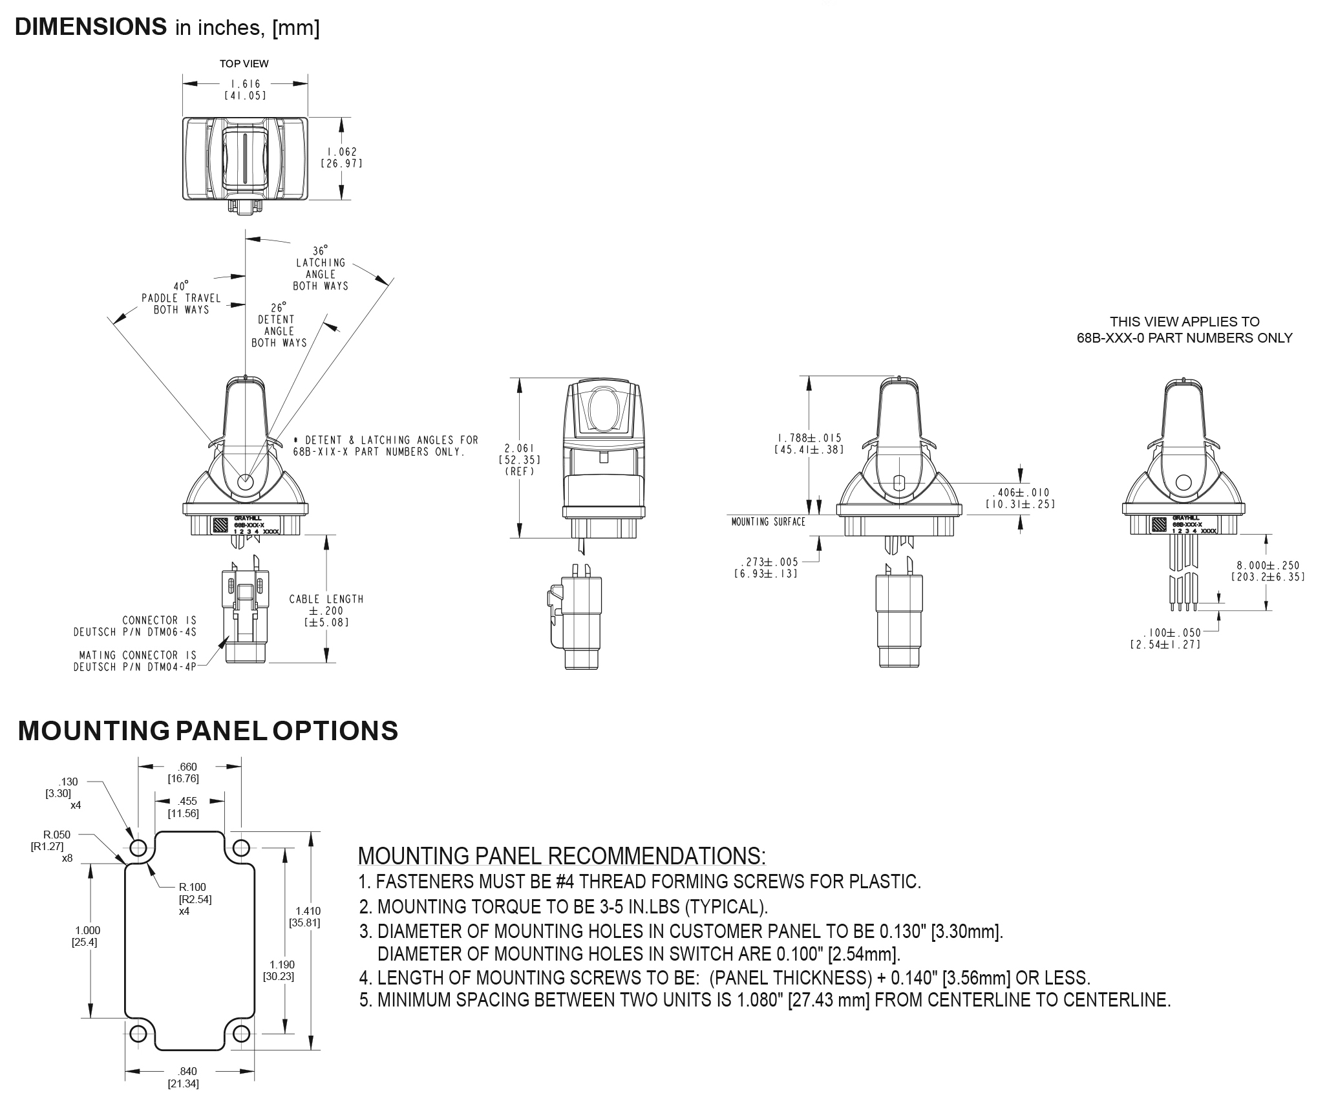
HARDWARE/JOYSTICKS/GRAYHILL_SERIES_68B/68b-drawing-01.jpg
