Aleixgelabert/TFM/HARDWARE/JOYSTICKS/GRAYHILL_SERIES_68B/68b-drawing-02.jpg

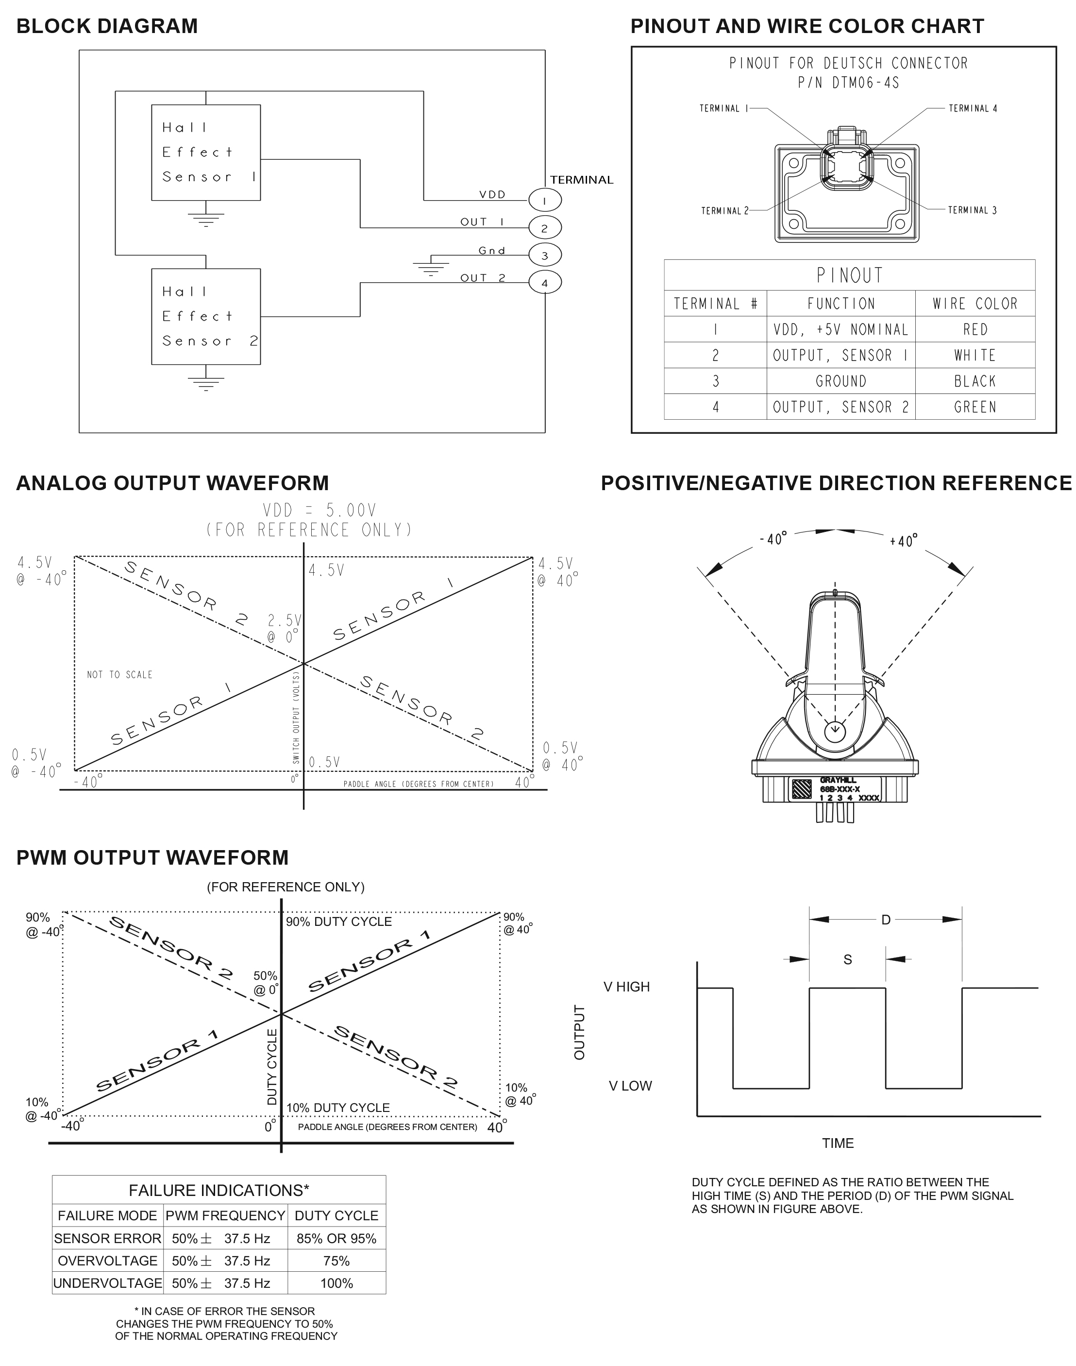
HARDWARE/JOYSTICKS/GRAYHILL_SERIES_68B/68b-drawing-02.jpg
