Aleixgelabert/TFM/HARDWARE/BUTTONS/BTL5/BTL5-3D-Drawing.stp

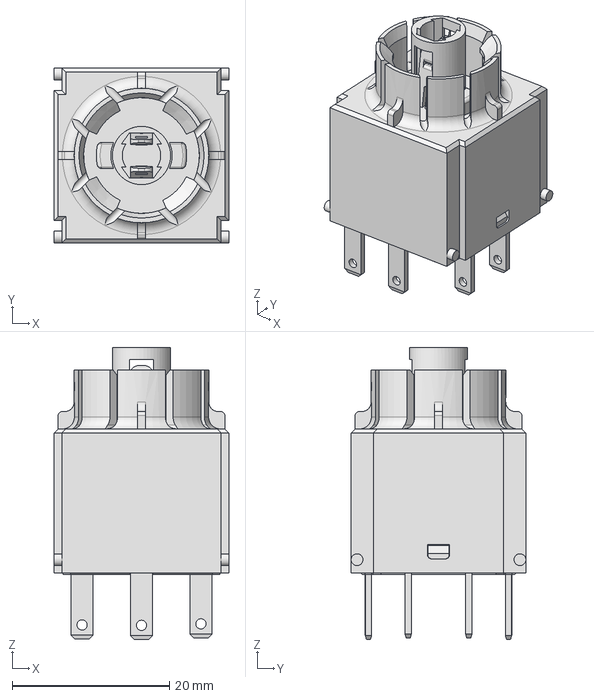
[picture p123: CAD file, 2026-03-20]
HARDWARE/BUTTONS/BTL5/BTL5-3D-Drawing.stp
22.2 x 22.2 x 37.1 mm
