Aleixgelabert/TFM/HARDWARE/COMANDAMENT/APEM_SERIES_AV/APEM-switches-AV-step.158/AV1630C9XX.stp

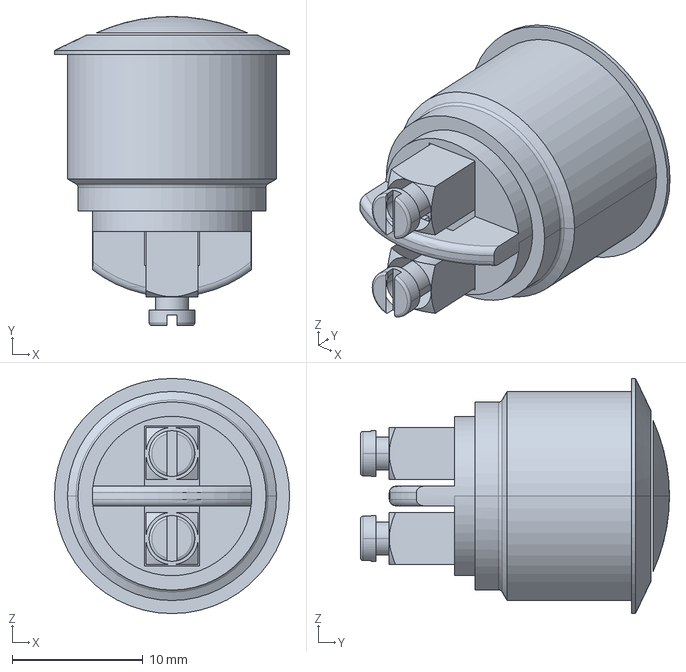
[picture p124: CAD file, 2026-03-20]
HARDWARE/COMANDAMENT/APEM_SERIES_AV/APEM-switches-AV-step.158/AV1630C9XX.stp
18.0 x 23.6 x 18.0 mm
