Aleixgelabert/TFM/HARDWARE/COMANDAMENT/CARCASSA/Funda_Joystick.3mf

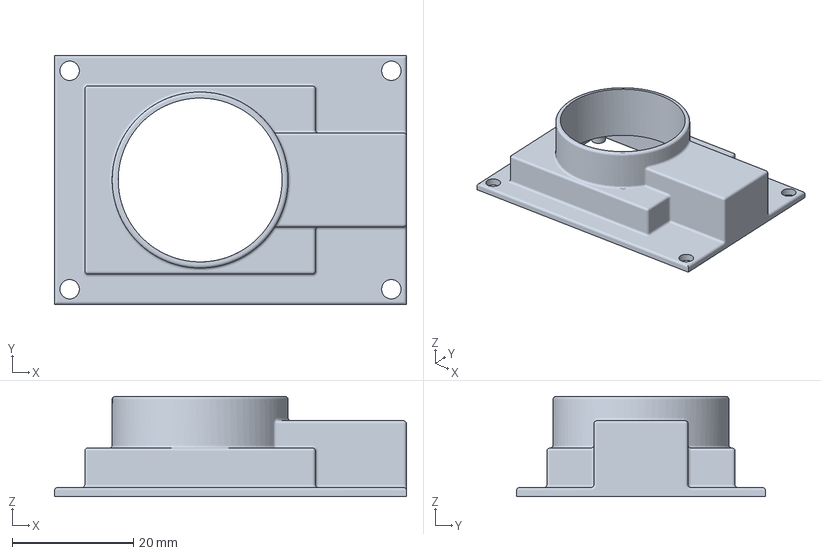
[picture p125: CAD file, 2026-04-09]
HARDWARE/COMANDAMENT/CARCASSA/Funda_Joystick.3mf
58.0 x 41.0 x 16.5 mm
