Aleixgelabert/TFM/HARDWARE/COMANDAMENT/EAO_SERIES_61/3d model_61-6441.4047.stp

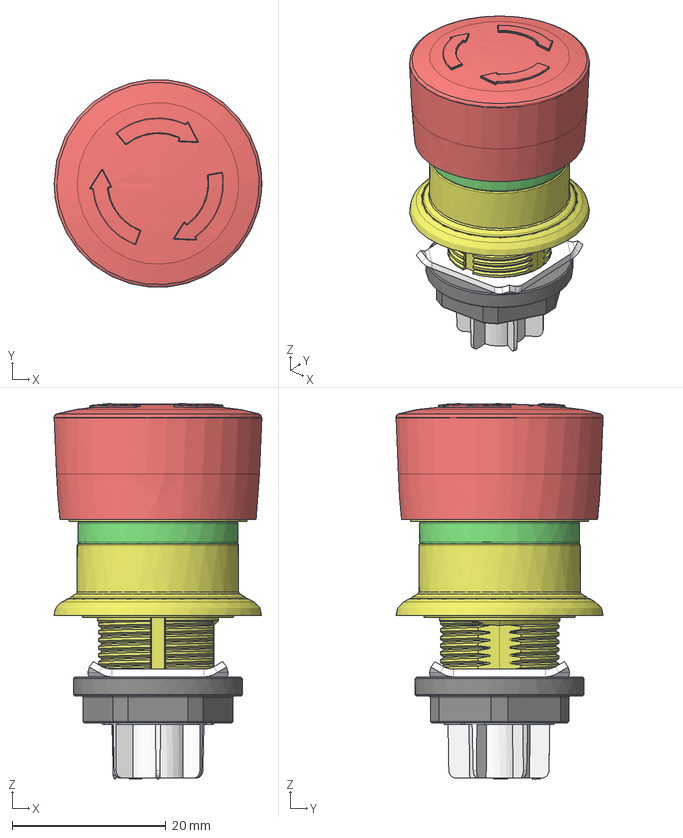
[picture p126: CAD file, 2026-03-20]
HARDWARE/COMANDAMENT/EAO_SERIES_61/3d model_61-6441.4047.stp
27.0 x 26.9 x 48.8 mm
Verdrehsicherungsring_00306128
Paneldichtung Ring_00454267
Halterung_Kontaktbrücke_00410868
Kontaktbrücke_NC_00410863
Pilzdruckhaube_00410850
Basisplatte_SE_00411010
Kontaktarm_NC_li_00410770
Betätiger_NC_00410886
Druckfeder_2__00494734_oa_3
Kontaktarm_NC_re_00410771
Gehaeuse_unterteil_00410847
Befestigungsmuffe_00410837
Anzeigering_00410848
Gehaeuse_oberteil_dreh_00410846
Paneldichtung_00410838
