Aleixgelabert/TFM/HARDWARE/JOYSTICKS/GRAYHILL_SERIES_68B/68b.stp

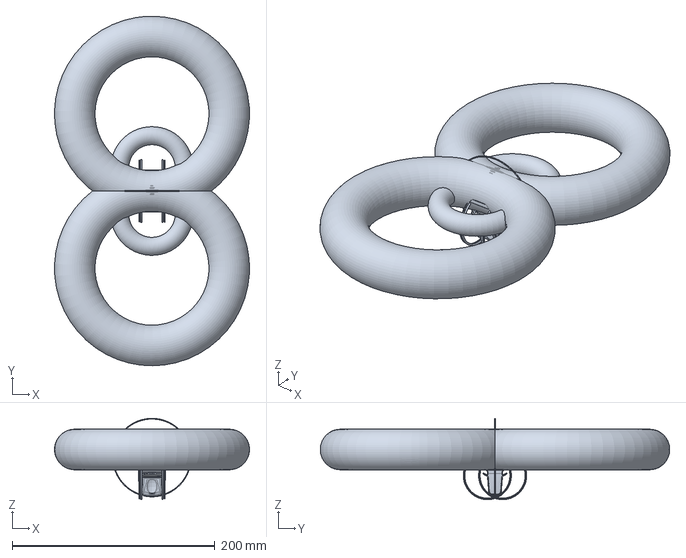
[picture p127: CAD file, 2026-03-20]
HARDWARE/JOYSTICKS/GRAYHILL_SERIES_68B/68b.stp
192.4 x 344.9 x 80.3 mm
