Aleixgelabert/TFM/HARDWARE/TOUCH ENCODER/GRAYHILL_FLUSHMOUNT/TE-Flushmount/TE-F33B-1-21X.stp

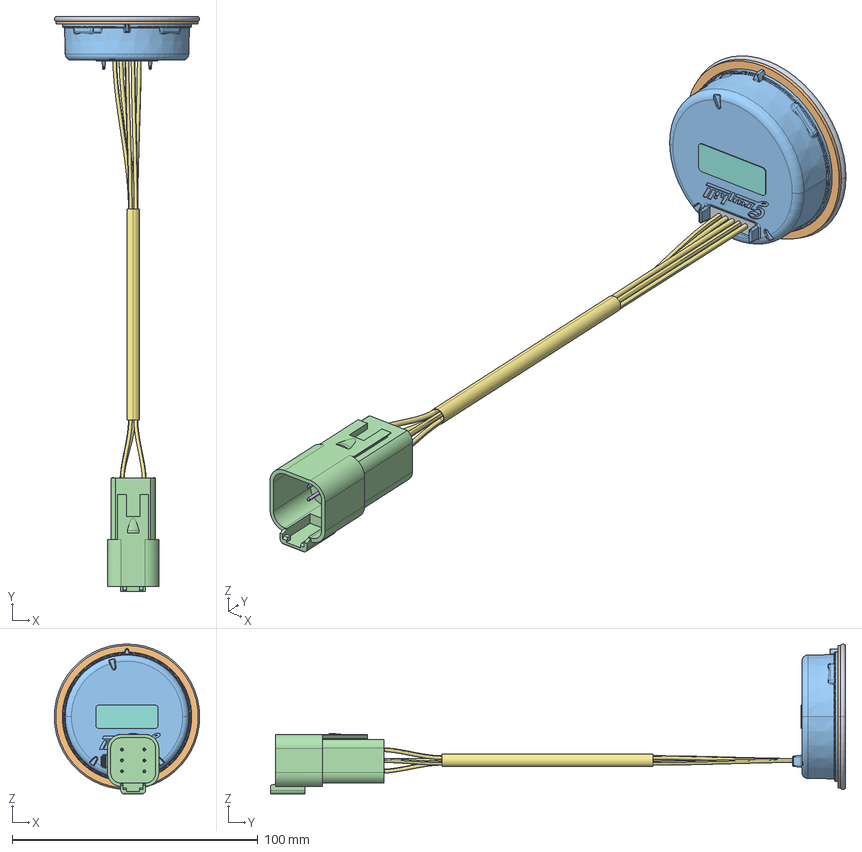
[picture p128: CAD file, 2025-11-30]
HARDWARE/TOUCH ENCODER/GRAYHILL_FLUSHMOUNT/TE-Flushmount/TE-F33B-1-21X.stp
59.2 x 233.9 x 61.0 mm
T10506-231
T15707-X
T11110
T1FC1023_INSTALLED_ASM
AW6P
T18911-XWIRES
SSS2427-34_TEYYF33001
TE-F33G-X-XXX_RTV
