Aleixgelabert/TFM/HARDWARE/BUTTONS/APEM_SERIES_KH/kh_corrig‚_10-04-2019/kh246fazdeg22n01xx02.stp

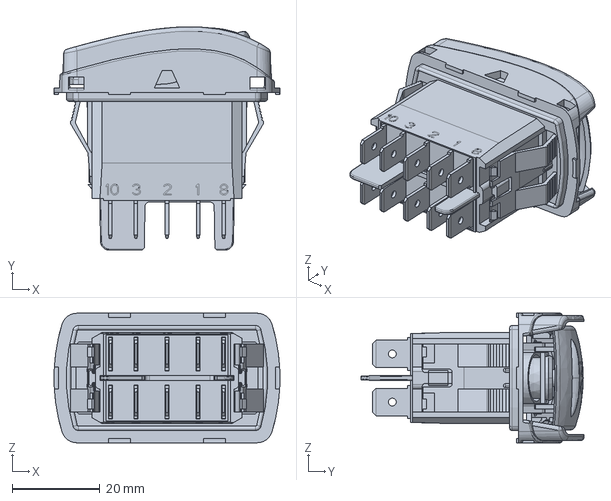
[picture p129: CAD file, 2026-03-20]
HARDWARE/BUTTONS/APEM_SERIES_KH/kh_corrig‚_10-04-2019/kh246fazdeg22n01xx02.stp
51.6 x 51.0 x 29.6 mm
