Aleixgelabert/TFM/HARDWARE/BUTTONS/BTL5/Push Button M19.step

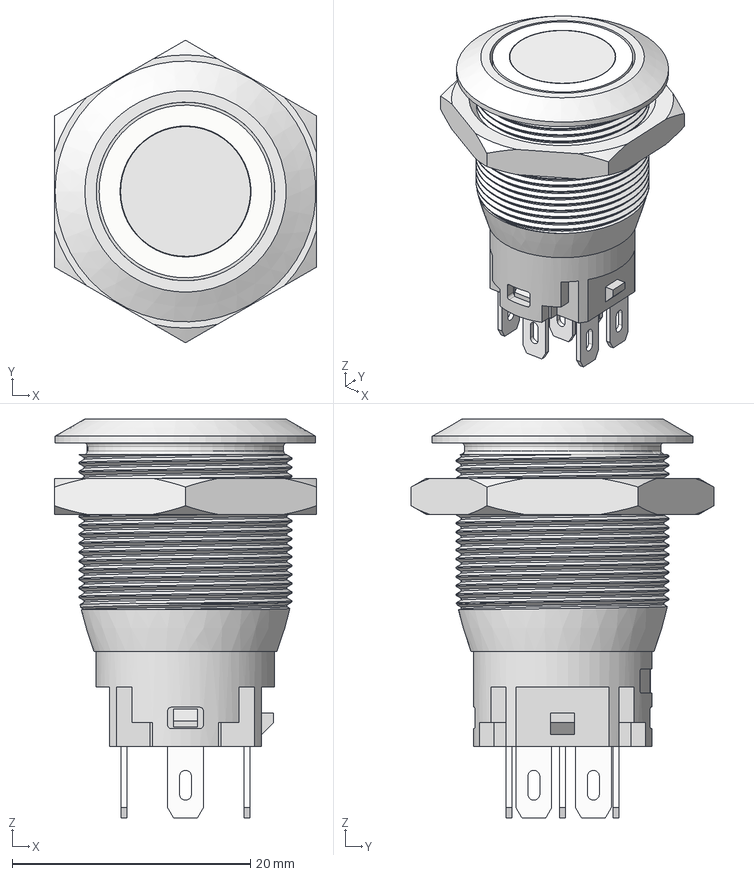
[picture p130: CAD file, 2026-03-20]
HARDWARE/BUTTONS/BTL5/Push Button M19.step
22.0 x 25.4 x 33.5 mm
корпус кнопки
кольцо рассеивателя
кнопка
контактная площадка LED
контактная площадка кнопки
Контакт x 5
Контакт(Mirror) x 2
Гайка М19 для кнопки
