Aleixgelabert/TFM/HARDWARE/COMANDAMENT/CARCASSA/Suport waveshare.3mf

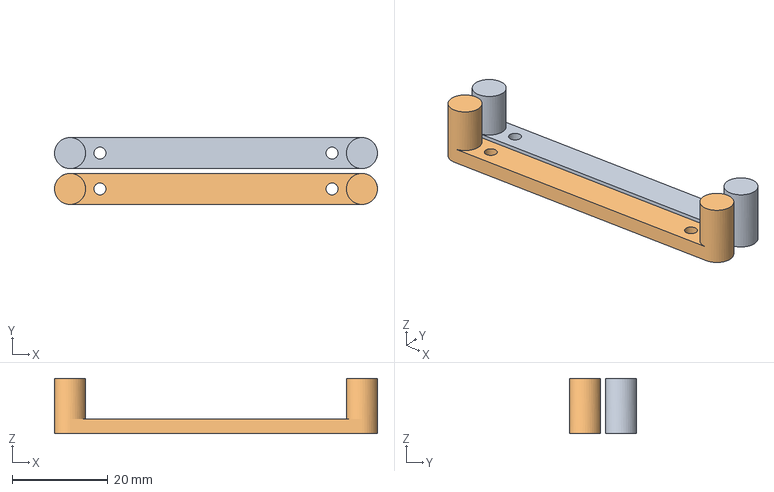
[picture p131: CAD file, 2026-03-22]
HARDWARE/COMANDAMENT/CARCASSA/Suport waveshare.3mf
67.5 x 14.0 x 11.5 mm
Cuerpo1 x 2
