Aleixgelabert/TFM/HARDWARE/TOUCH ENCODER/GRAYHILL_FLUSHMOUNT/TE-Flushmount/TE-F33B-1-11X.stp

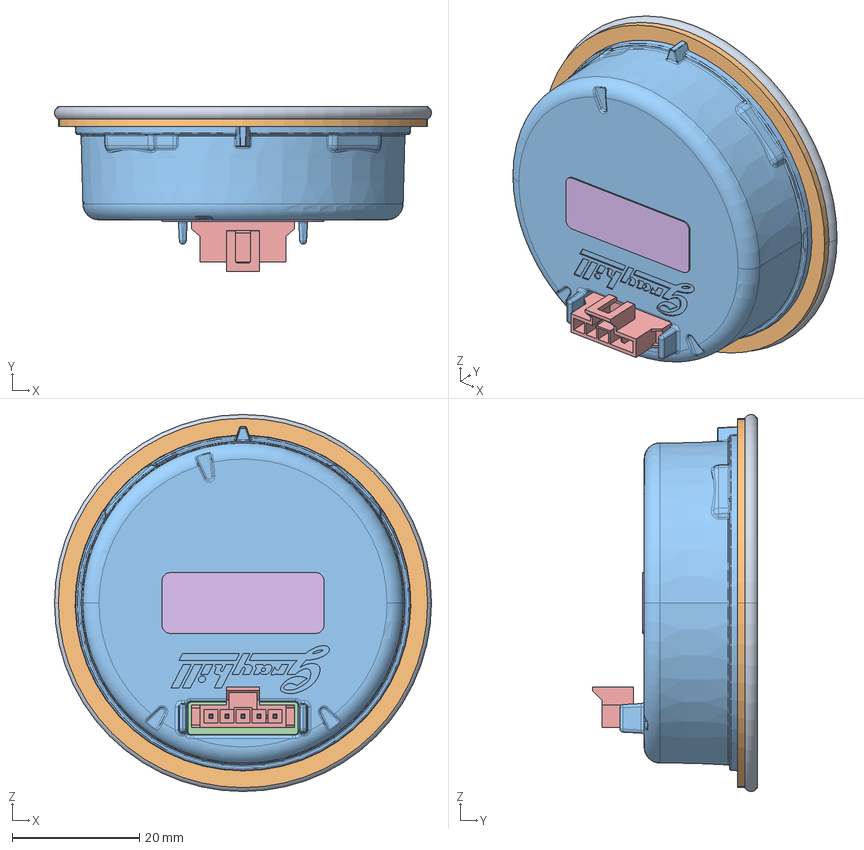
[picture p132: CAD file, 2025-11-30]
HARDWARE/TOUCH ENCODER/GRAYHILL_FLUSHMOUNT/TE-Flushmount/TE-F33B-1-11X.stp
59.2 x 25.9 x 59.2 mm
T10517-X
T15707-X
T11110
T1FC1023_FR4
SCN4215-0928
SSS2427-34_TE-F33B-1-11X
