Aleixgelabert/TFM/HARDWARE/COMANDAMENT/APEM_SERIES_AV/APEM-switches-AV-step.158/av19lp404.stp

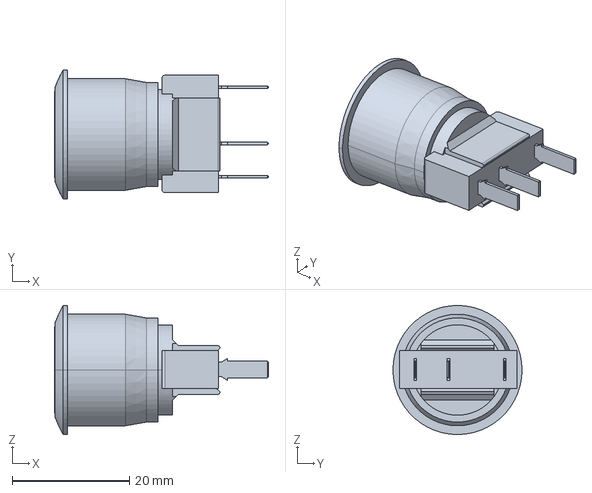
[picture p133: CAD file, 2026-03-20]
HARDWARE/COMANDAMENT/APEM_SERIES_AV/APEM-switches-AV-step.158/av19lp404.stp
36.5 x 22.0 x 22.0 mm
