Aleixgelabert/TFM/HARDWARE/COMANDAMENT/APEM_SERIES_AV/APEM-switches-AV-step.158/av0730c940.stp

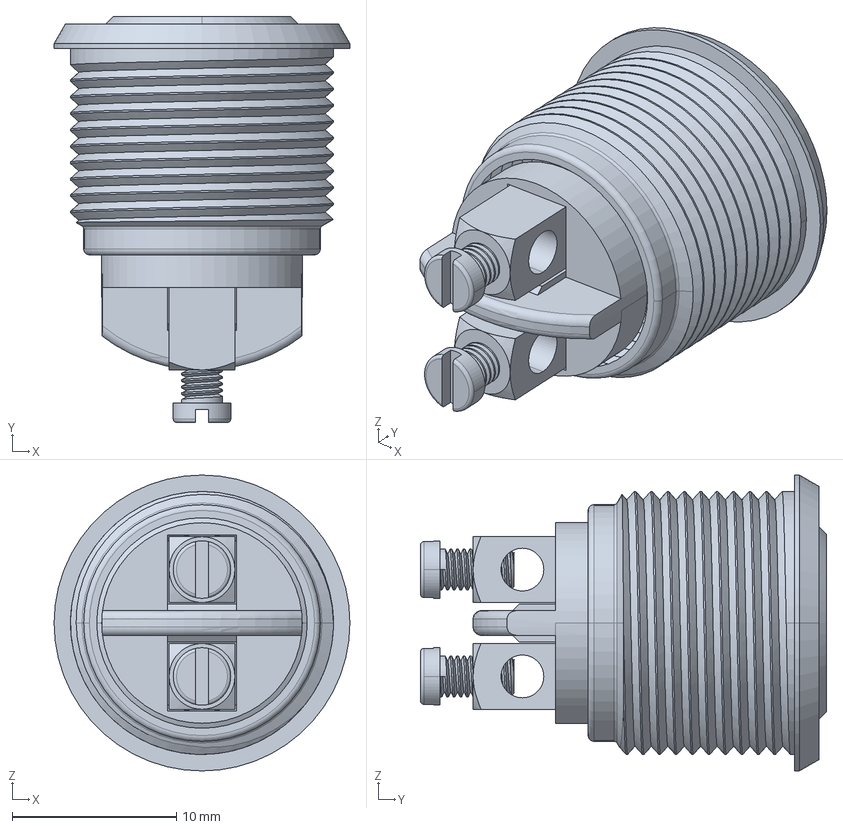
[picture p134: CAD file, 2026-03-20]
HARDWARE/COMANDAMENT/APEM_SERIES_AV/APEM-switches-AV-step.158/av0730c940.stp
18.0 x 24.7 x 18.0 mm
