Aleixgelabert/TFM/HARDWARE/COMANDAMENT/APEM_SERIES_AV/APEM-switches-AV-step.158/av24lp464.stp

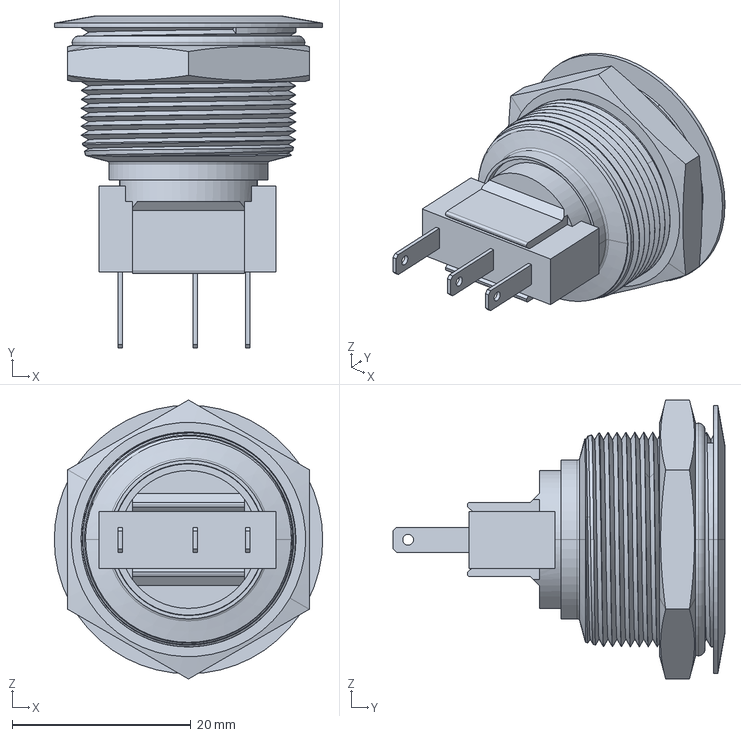
[picture p135: CAD file, 2026-03-20]
HARDWARE/COMANDAMENT/APEM_SERIES_AV/APEM-switches-AV-step.158/av24lp464.stp
30.0 x 37.1 x 31.2 mm
