Aleixgelabert/TFM/HARDWARE/COMANDAMENT/APEM_SERIES_AV/APEM-switches-AV-step.158/AV9SLD9xxx002.stp

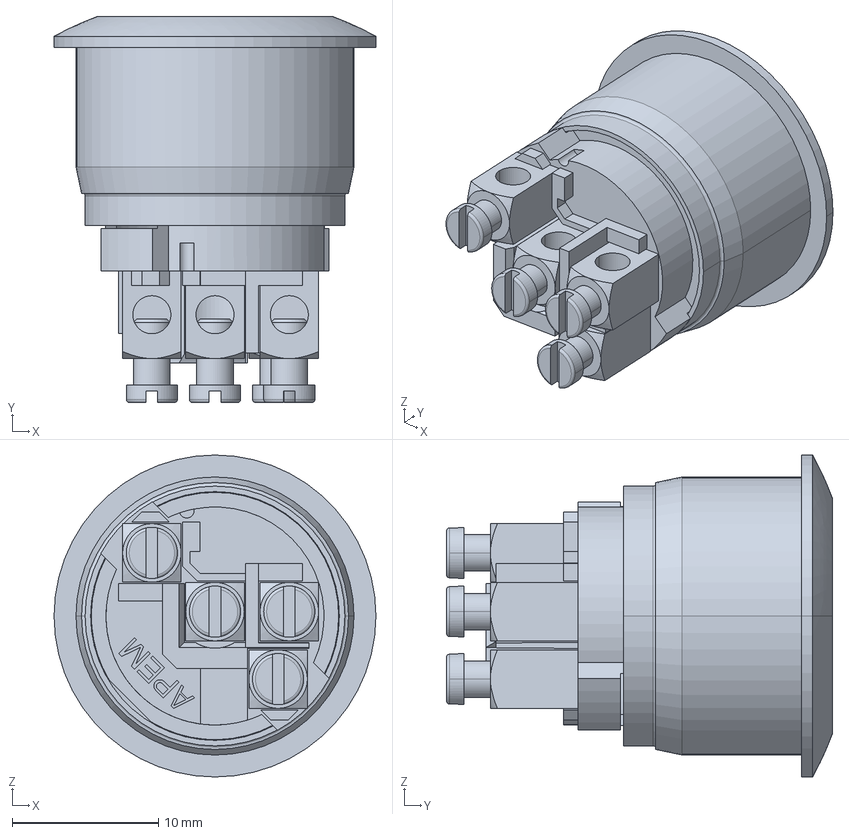
[picture p136: CAD file, 2026-03-20]
HARDWARE/COMANDAMENT/APEM_SERIES_AV/APEM-switches-AV-step.158/AV9SLD9xxx002.stp
22.0 x 26.4 x 22.0 mm
