Aleixgelabert/TFM/HARDWARE/COMANDAMENT/APEM_SERIES_AV/APEM-switches-AV-step.158/av9x0420000xxx.stp

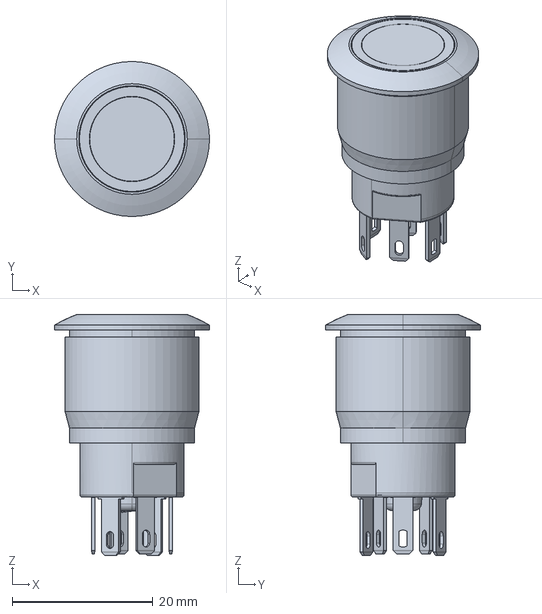
[picture p137: CAD file, 2026-03-20]
HARDWARE/COMANDAMENT/APEM_SERIES_AV/APEM-switches-AV-step.158/av9x0420000xxx.stp
22.0 x 22.0 x 34.2 mm
