Aleixgelabert/TFM/HARDWARE/COMANDAMENT/APEM_SERIES_AV/APEM-switches-AV-step.158/av09c7l3d900xk.stp

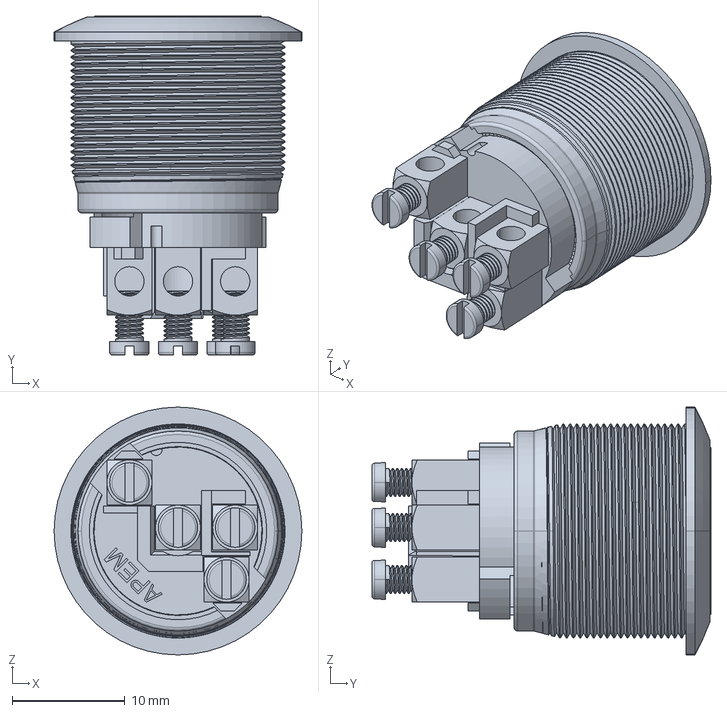
[picture p153: CAD file, 2026-03-20]
HARDWARE/COMANDAMENT/APEM_SERIES_AV/APEM-switches-AV-step.158/av09c7l3d900xk.stp
22.0 x 30.1 x 22.0 mm
