Aleixgelabert/TFM/HARDWARE/COMANDAMENT/APEM_SERIES_AV/APEM-switches-AV-step.158/av9sld2x8x011k.stp

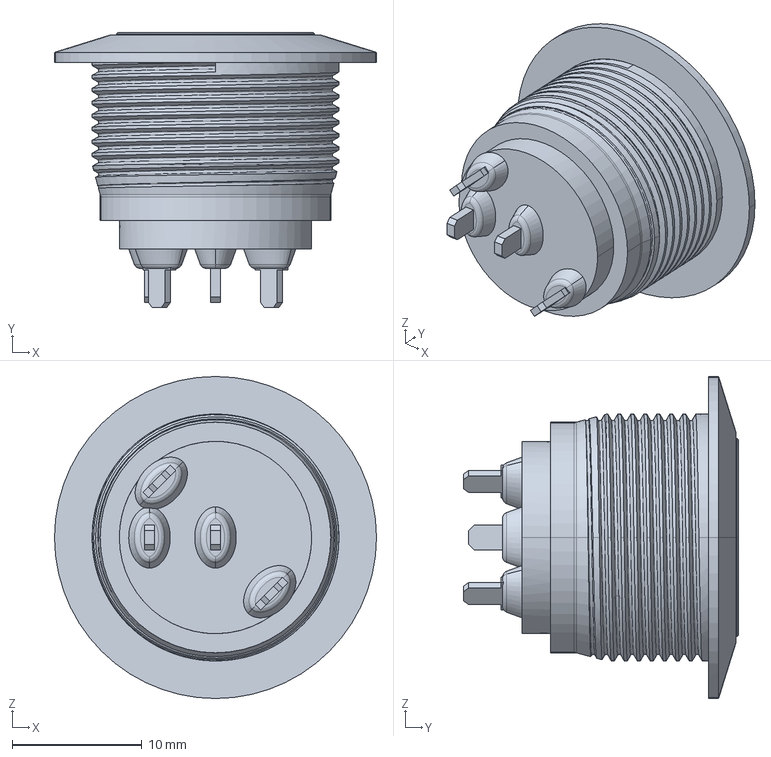
[picture p158: CAD file, 2026-03-20]
HARDWARE/COMANDAMENT/APEM_SERIES_AV/APEM-switches-AV-step.158/av9sld2x8x011k.stp
24.8 x 21.2 x 24.8 mm
