Aleixgelabert/TFM/(list of files, cad)

Other CAD files:
HARDWARE/COMANDAMENT/WAVESHARE/ESP32-S3-Touch-LCD-3-Dimensions/ESP32-S3-Touch-LCD-3.5-C.dwg
HARDWARE/EXISTENT SKORPIOS/EL1512/ethercat-_busterminal_12mm_8_pin_pluggable_wiring_level.dxf
HARDWARE/EXISTENT SKORPIOS/EL1808/ethercat-_busterminal_12mm_16_pin.dxf
HARDWARE/EXISTENT SKORPIOS/EL2828/ethercat-_busterminal_12mm_16_pin.dxf
HARDWARE/EXISTENT SKORPIOS/EL3068/ethercat-_busterminal_12mm_8_pin.dxf
HARDWARE/EXISTENT SKORPIOS/EL4104/ethercat-_busterminal_12mm_8_pin.dxf
HARDWARE/EXISTENT SKORPIOS/EL6751/ethercat_terminal_24mm_1xd_sub_male.dxf
HARDWARE/EXISTENT SKORPIOS/EL9186 (PWR FARO)/ethercat-_busterminal_12mm_8_pin_pluggable_wiring_level.dxf
HARDWARE/COMANDAMENT/WAVESHARE/ESP32-S3-Touch-LCD-3-Dimensions/ESP32-S3-Touch-LCD-3.5.dwg
HARDWARE/EXISTENT SKORPIOS/EL1512/ethercat-_busterminal_12mm_8_pin.dxf
HARDWARE/EXISTENT SKORPIOS/EL4104/ethercat-_busterminal_12mm_8_pin_pluggable_wiring_level.dxf
HARDWARE/EXISTENT SKORPIOS/EL9186 (PWR FARO)/ethercat-_busterminal_12mm_8_pin.dxf
HARDWARE/COMANDAMENT/APEM_SERIES_AV/APEM-switches-AV-step.158/av9sld2611001.stp
HARDWARE/COMANDAMENT/APEM_SERIES_AV/APEM-switches-AV-step.158/av9222f1020840k.stp
HARDWARE/COMANDAMENT/APEM_SERIES_AV/APEM-switches-AV-step.158/av3222f1020840.stp
HARDWARE/COMANDAMENT/APEM_SERIES_AV/APEM-switches-AV-step.158/av9sld2633011.stp
HARDWARE/COMANDAMENT/APEM_SERIES_AV/APEM-switches-AV-step.158/AV044746A240k.stp
HARDWARE/COMANDAMENT/APEM_SERIES_AV/APEM-switches-AV-step.158/av021003c900.stp
HARDWARE/COMANDAMENT/APEM_SERIES_AV/APEM-switches-AV-step.158/av021202a970_.stp
HARDWARE/COMANDAMENT/APEM_SERIES_AV/APEM-switches-AV-step.158/av031001a200k.stp
HARDWARE/COMANDAMENT/APEM_SERIES_AV/APEM-switches-AV-step.158/av031003c910.stp
HARDWARE/COMANDAMENT/APEM_SERIES_AV/APEM-switches-AV-step.158/av03100ea200.stp
HARDWARE/COMANDAMENT/APEM_SERIES_AV/APEM-switches-AV-step.158/av061001a200.stp
HARDWARE/COMANDAMENT/APEM_SERIES_AV/APEM-switches-AV-step.158/av090003a940kuu.stp
HARDWARE/COMANDAMENT/APEM_SERIES_AV/APEM-switches-AV-step.158/av091003c900.stp
HARDWARE/COMANDAMENT/APEM_SERIES_AV/APEM-switches-AV-step.158/av091003c9XXX.stp
HARDWARE/COMANDAMENT/APEM_SERIES_AV/APEM-switches-AV-step.158/av09100ea200.stp
HARDWARE/COMANDAMENT/APEM_SERIES_AV/APEM-switches-AV-step.158/av190003a940kuu.stp
HARDWARE/COMANDAMENT/APEM_SERIES_AV/APEM-switches-AV-step.158/av191001a200k.stp
HARDWARE/COMANDAMENT/APEM_SERIES_AV/APEM-switches-AV-step.158/av191003c9.stp
HARDWARE/COMANDAMENT/APEM_SERIES_AV/APEM-switches-AV-step.158/av191003c900.stp
HARDWARE/COMANDAMENT/APEM_SERIES_AV/APEM-switches-AV-step.158/av351200000700.stp
HARDWARE/COMANDAMENT/APEM_SERIES_AV/APEM-switches-AV-step.158/av900220000840k.stp
HARDWARE/COMANDAMENT/CARCASSA/Suport waveshare.f3d
HARDWARE/TOUCH ENCODER/GRAYHILL_FLUSHMOUNT/TE-Flushmount/TE-F33B-1-11X.igs
HARDWARE/TOUCH ENCODER/GRAYHILL_FLUSHMOUNT/TE-Flushmount/TE-F33B-1-21X.igs
