Aleixgelabert/TFM/DOCS/ANNEXOS/Annex III - Manual-Nautor CS125 Rev0 p81.pdf

## Section 04 HYDRAULIC DEVICES – DATA SHEETS

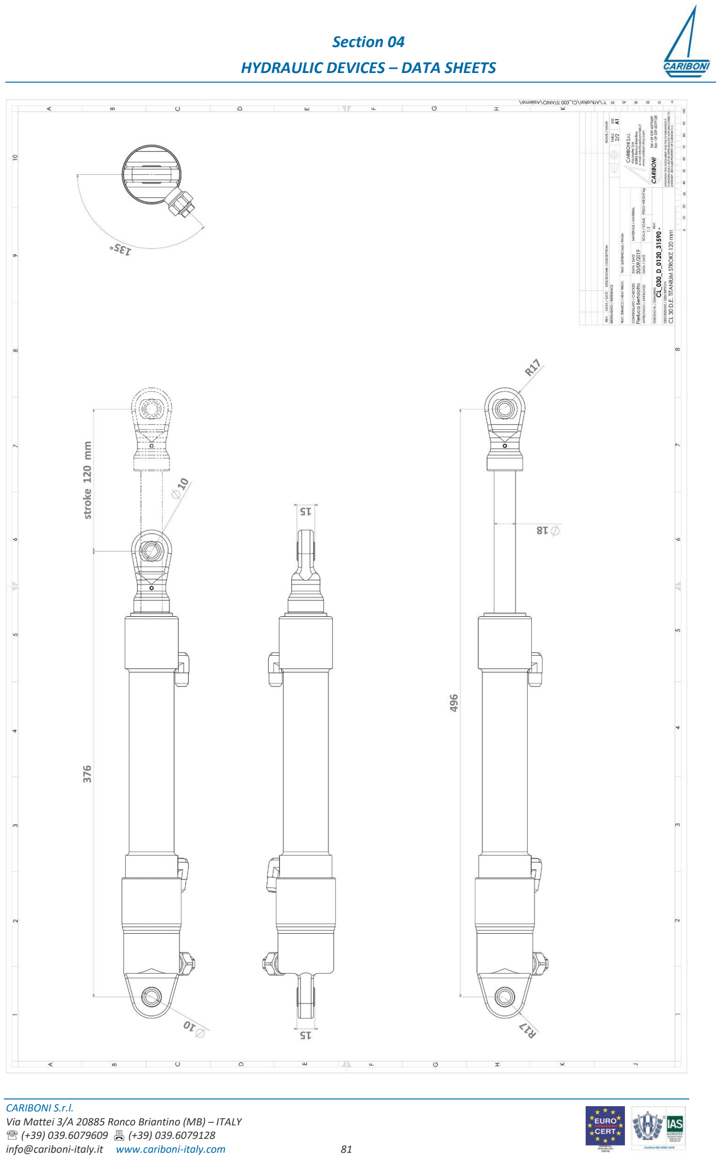
[picture p170: page 1]

CARIBONI S.r.l.
Via Mattei 3/A 20885 Ronco Briantino (MB) – ITALY
(+39) 039.6079609 | (+39) 039.6079128
info@cariboni-italy.it www.cariboni-italy.com | 81
