Aleixgelabert/TFM/HARDWARE/ALIMENTACIÓ/XL6009E1/5v-32v-input-to-15v-35v-output-xl6009-boost-buck-step-up-step-down-dc-dc-converter-847745_1024x1024.jpg.webp

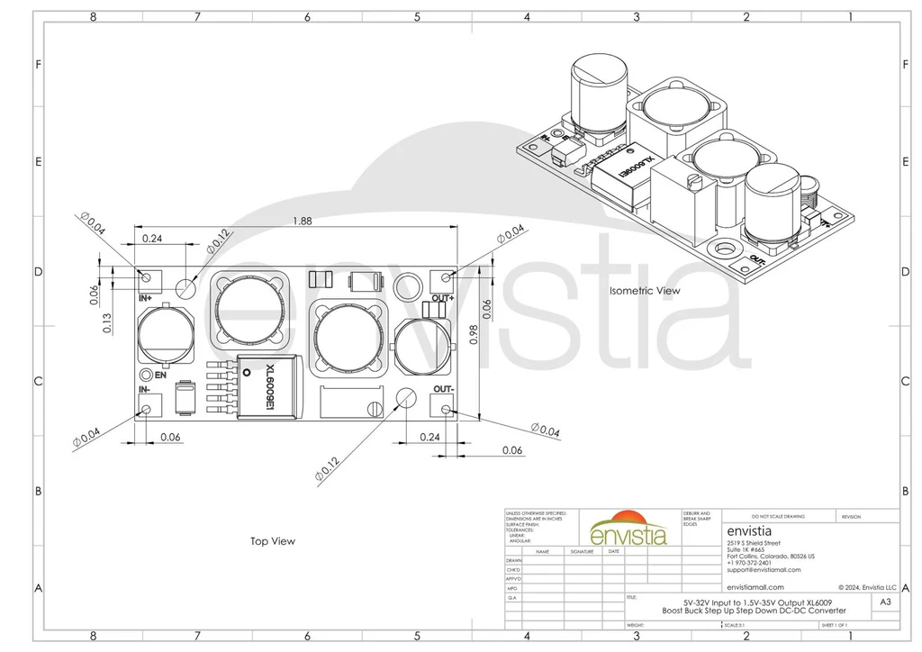
HARDWARE/ALIMENTACIÓ/XL6009E1/5v-32v-input-to-15v-35v-output-xl6009-boost-buck-step-up-step-down-dc-dc-converter-847745_1024x1024.jpg.webp
