Aleixgelabert/TFM/HARDWARE/ALIMENTACIÓ/XL6009E1/Envistia_xl6009_dc-dc_boost_dimensional_drawing.pdf

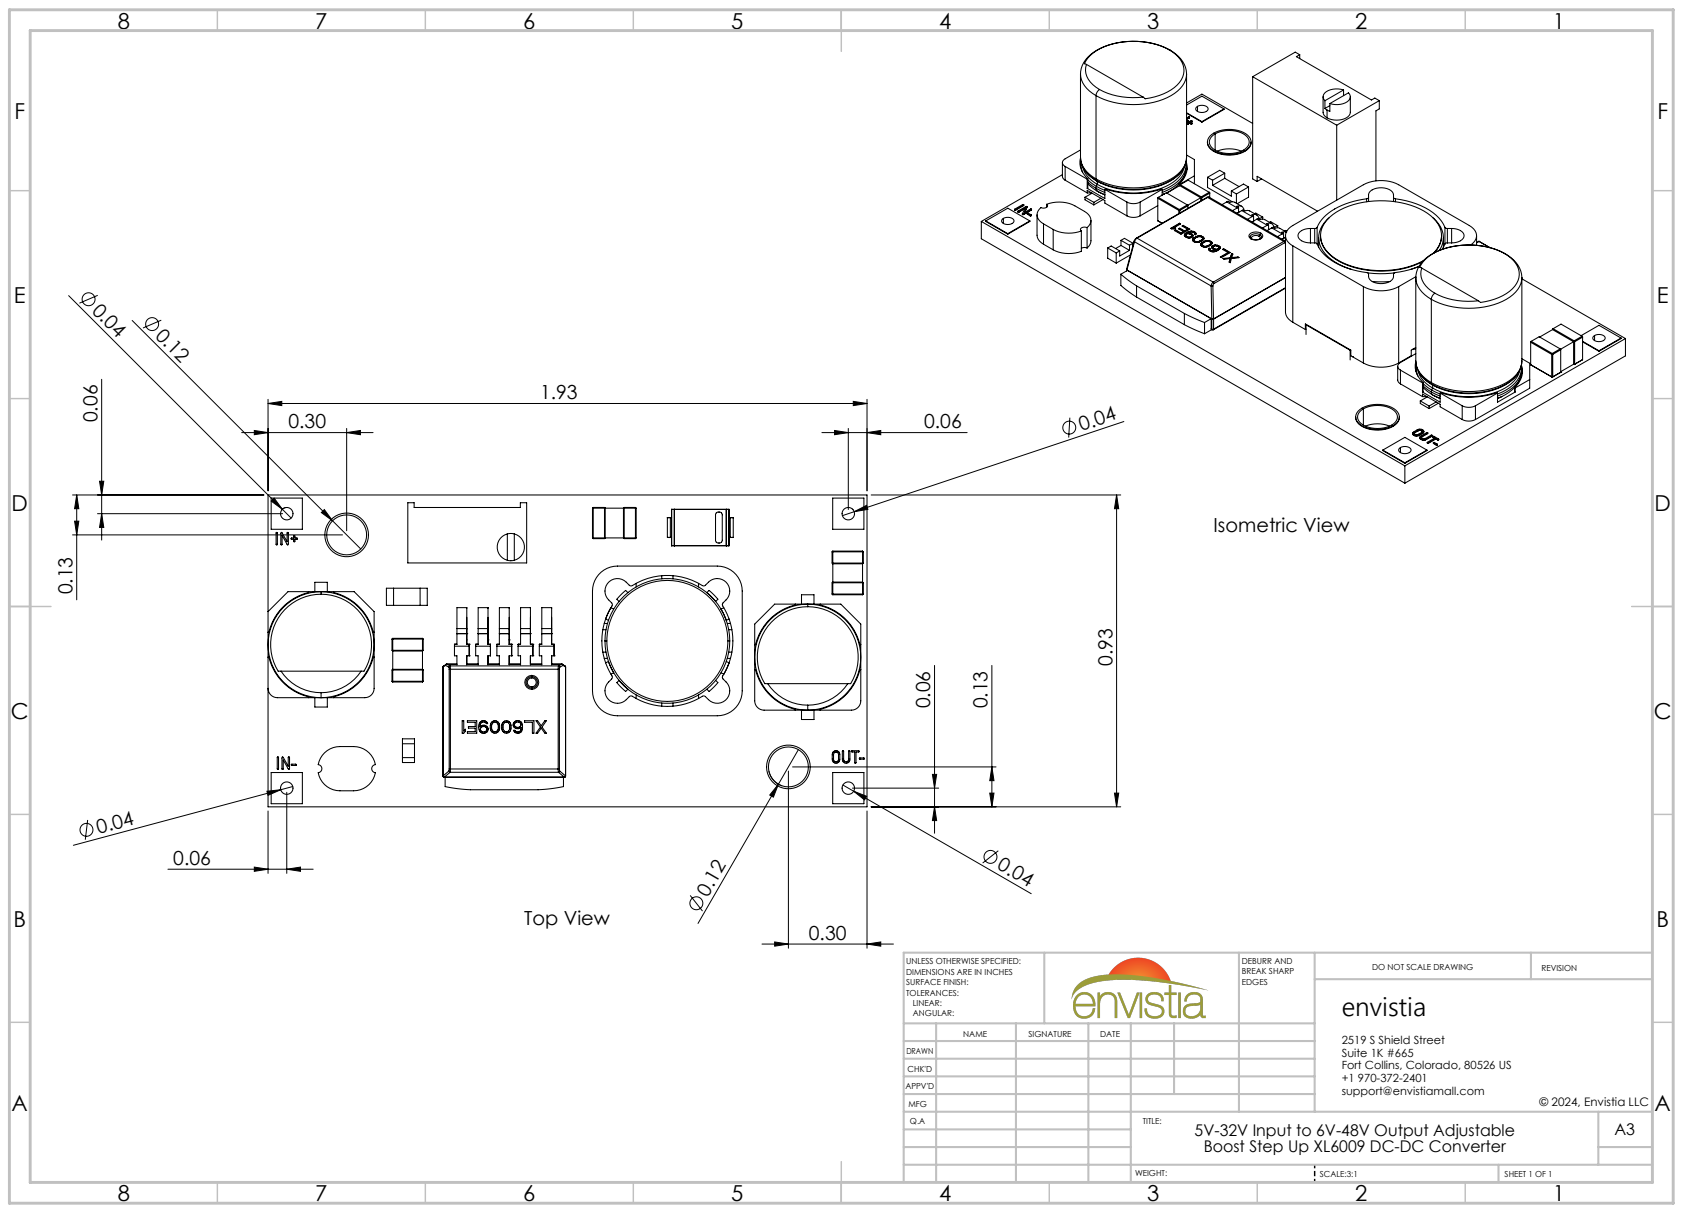
[picture p221: page 1]
Isometric View; Top View; © 2024, Envistia LLC; DEBURR AND BREAK SHARP; DO NOT SCALE DRAWING; REVISION; SCALE:3:1; SHEET 1 OF 1

UNLESS OTHERWISE SPECIFIED:
DIMENSIONS ARE IN INCHES
SURFACE FINISH:
TOLERANCES:
LINEAR:
ANGULAR:

NAME | SIGNATURE | DATE

2519 S Shield Street
Suite 1K #665
Fort Collins, Colorado, 80526 US
support@envistiamall.com

DRAWN
CHK'D
APPV'D
MFG
Q.A | | | | TITLE: 5V-32V Input to 6V-48V Output Adjustable Boost Step Up XL6009 DC-DC Converter | A3
