Aleixgelabert/TFM/HARDWARE/ALIMENTACIÓ/XL6009E1/XL6009-Schematic-Diagram.pdf

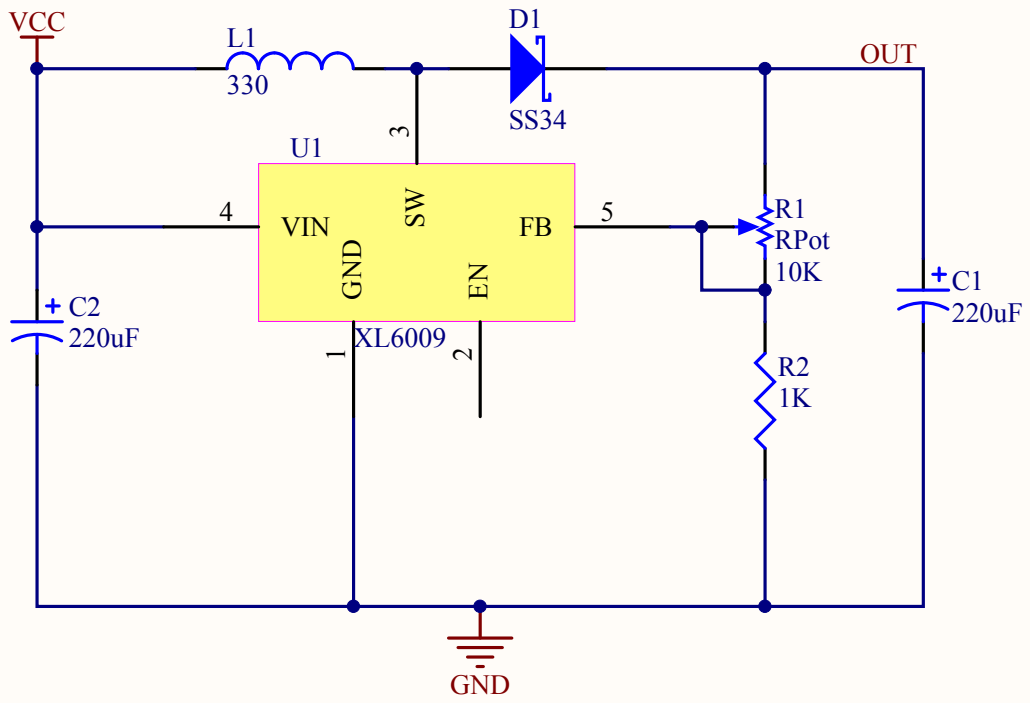
[picture p222: page 1]
