Aleixgelabert/TFM/HARDWARE/COMANDAMENT/WAVESHARE/ESP32-S3-Touch-LCD-3-Dimensions/ESP32-S3-Touch-LCD-3.5-C.pdf

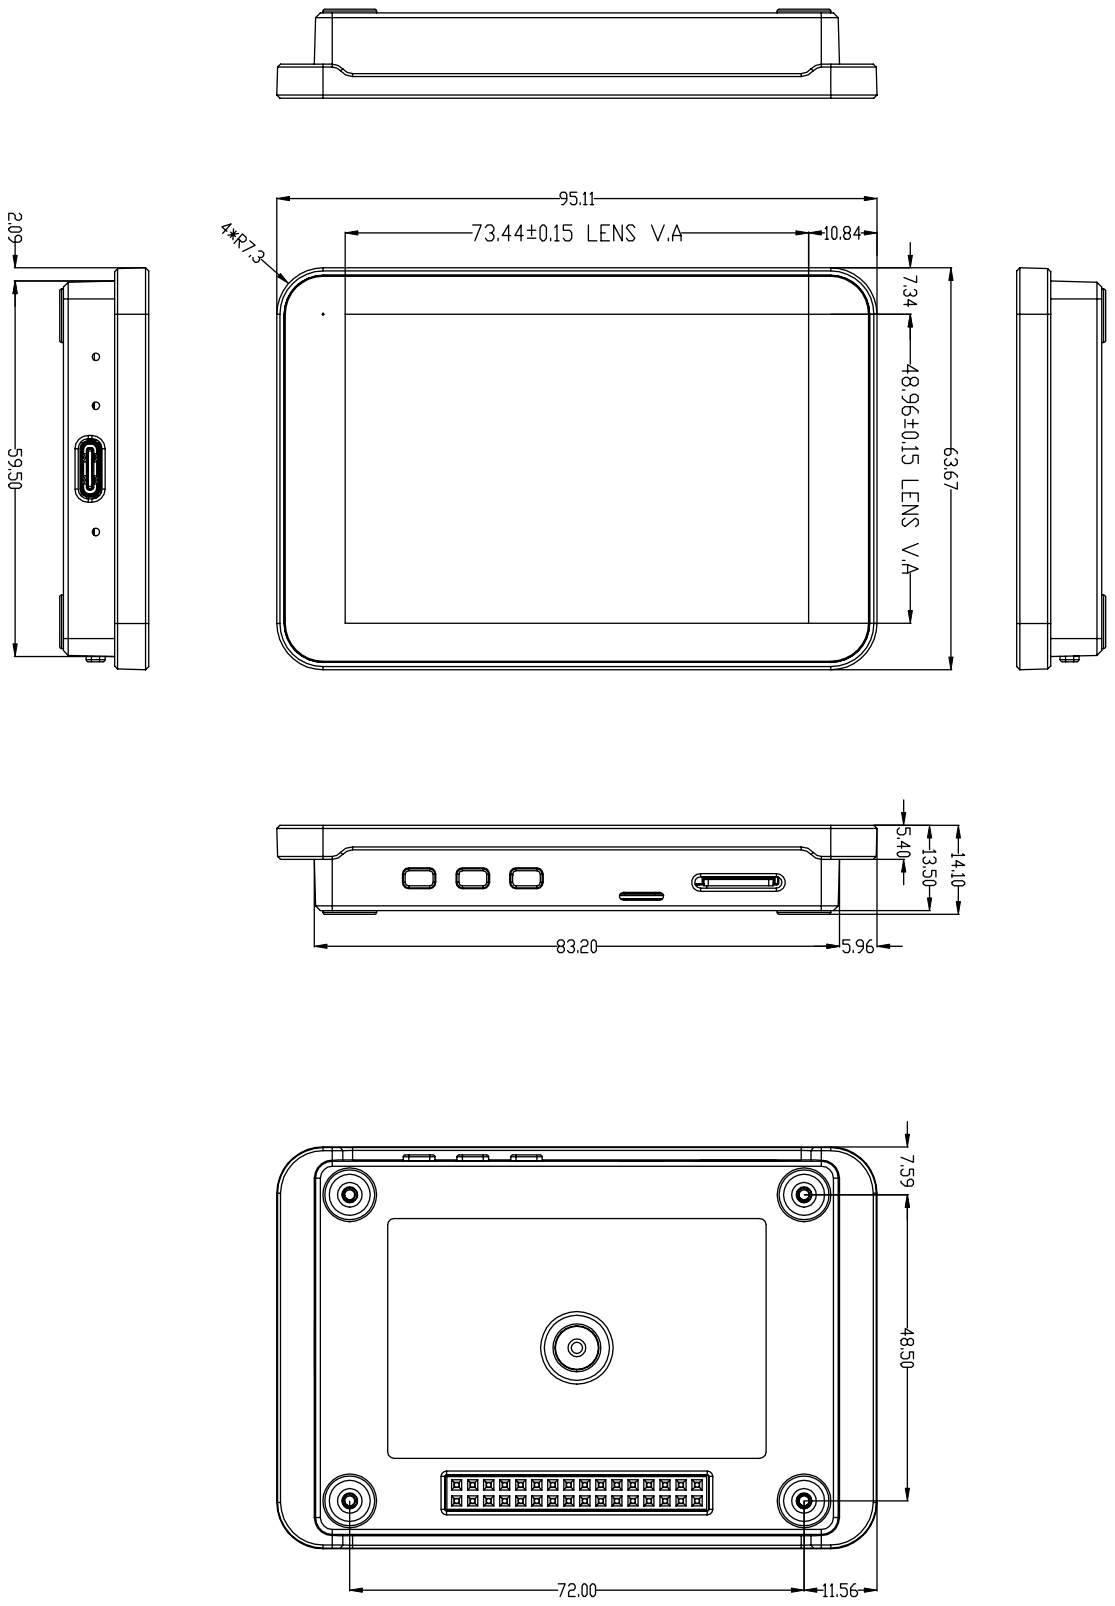
[picture p223: page 1]
