Aleixgelabert/TFM/HARDWARE/COMANDAMENT/WAVESHARE/ESP32-S3-Touch-LCD-3-Dimensions/ESP32-S3-Touch-LCD-3.5.pdf

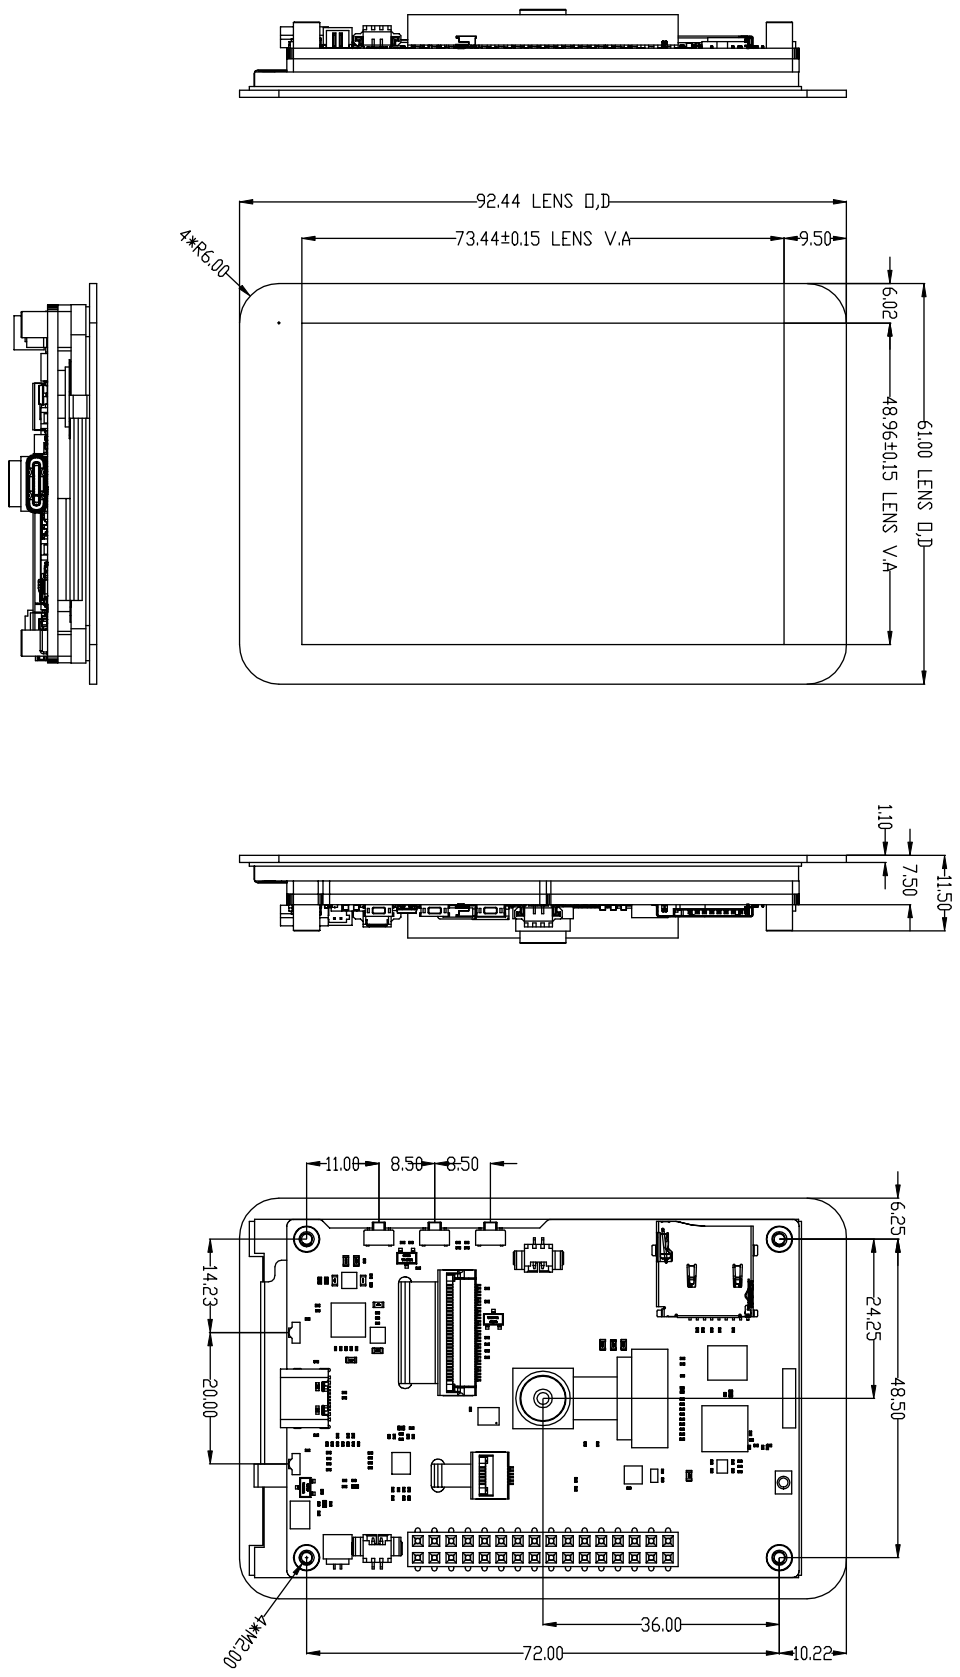
[picture p224: page 1]
