Aleixgelabert/TFM/(list of files, drawings)

Other design files:
HARDWARE/SCREENS/ILI9488/LAFVIN/Altium_3.5_48pin_QD3503_Package_library/3.5inch_48pin_QD3503.PcbLib
HARDWARE/SCREENS/ILI9488/LAFVIN/Altium_3.5_48pin_QD3503_Package_library/3.5inch_48pin_QD3503.SchLib
