Aleixgelabert/TFM/SOFTWARE/SEGON_ESP32/SERVO/main/servo.cpp

// Arxiu servo.cpp
// ESP32 actua com a punt d'accés i envia dades UDP cada segon a la pantalla (192.168.4.2)
// La pantalla (192.168.4.2) envia senyal vx i vy del moviment del joystick

#include <string>
#include <cstring>
#include <cstdio>
#include <cmath>

extern "C" {
#include "freertos/FreeRTOS.h"
#include "freertos/task.h"
#include "esp_wifi.h"
#include "esp_event.h"
#include "esp_log.h"
#include "nvs_flash.h"
#include "esp_netif.h"
#include "lwip/sockets.h"
#include "driver/gpio.h"
#include "esp_rom_sys.h"
#include "esp_timer.h"
#include "driver/mcpwm.h"
}

static const char *TAG = "ESP32";

/* ---------- WI-FI CONFIG ---------------------- */
#define WIFI_SSID       "WIFI_ESP32"
#define WIFI_PASS       "12345678"
#define UDP_PORT        3333
#define RECEIVER_IP     "192.168.4.2"   // IP del dispositiu receptor
#define RECV_BUF_SIZE   64

/* ---------- SENSOR DISTÀNCIA CONFIG ---------------------- */
#define TRIG_PIN        GPIO_NUM_17
#define ECHO_PIN        GPIO_NUM_18

/* ---------- SERVO CONFIG ---------------------- */
#define SERVO_GPIO      GPIO_NUM_5
#define SERVO_MIN_US    500
#define SERVO_MAX_US    2500

// Valor de vx rebut per UDP (0-180)
static float vx_value = 90;   // inici al centre
static float vy_value = 0;  // reservat per altres usos
static int btn_pressed = 0; // variable global
static float last_angle = 90;   // memòria de posició


// -----------------------------------------------------------------------------
// CONTROL DE PAQUETS (ESP32 ↔ COM)
// -----------------------------------------------------------------------------

// TX ESP → RX COM (el que envia ESP32)
static uint32_t seq_esp = 0;
static uint32_t tx_esp = 0;

// TX COM → RX ESP (el que rep del comandament)
static uint32_t last_seq_com = 0;
static uint32_t rx_com = 0;
static uint32_t lost_com = 0;

static void update_rx_com(uint32_t seq)
{
    rx_com++;

    if (rx_com > 1 && seq > last_seq_com + 1) {
        lost_com += (seq - last_seq_com - 1);
    }

    last_seq_com = seq;
}

static float loss_com_percent()
{
    uint32_t total = rx_com + lost_com;
    return (total > 0) ? (100.0f * lost_com / total) : 0.0f;
}

/* ---------- PARSE UDP ---------- */
int parse_vx_vy_from_msg(const char *msg, float *raw_vx, float *raw_vy)
{
    const char *px = strstr(msg, "VX=");
    if (px) {
        *raw_vx = atof(px + 3);   // converteix el que hi ha després de "VX="
        if (*raw_vx < 0) *raw_vx = 0;
        if (*raw_vx > 4095) *raw_vx = 4095;
        *raw_vx = (*raw_vx * 180) / 4095; // normalitza a 0..180 graus
    }

    const char *py = strstr(msg, "VY=");
    if (py) {
        *raw_vy = atof(py + 3);
        if (*raw_vy < 0) *raw_vy = 0;
        if (*raw_vy > 4095) *raw_vy = 4095;
        *raw_vy = (*raw_vy * 180) / 4095; // normalitza a 0..180 graus, també es pot deixar 0..4095 per altres funcions
    }

    const char *pb = strstr(msg, "BTN=");
    if (pb) {
        btn_pressed = atoi(pb + 4); // 1 si premut, 0 si no
    }

    return 0;
}

/* ---------------------------------------- */
static void init_wifi_ap();
static float read_distance_cm();
static void udp_send_task(void *arg);

/* ---------- Wi-Fi Access Point ---------- */
static void init_wifi_ap()
{
    ESP_LOGI(TAG, "Inicialitzant NVS...");
    esp_err_t ret = nvs_flash_init();
    if (ret == ESP_ERR_NVS_NO_FREE_PAGES || ret == ESP_ERR_NVS_NEW_VERSION_FOUND) {
        ESP_ERROR_CHECK(nvs_flash_erase());
        ret = nvs_flash_init();
    }
    ESP_ERROR_CHECK(ret);

    ESP_ERROR_CHECK(esp_netif_init());
    ESP_ERROR_CHECK(esp_event_loop_create_default());
    esp_netif_create_default_wifi_ap();

    wifi_init_config_t cfg = WIFI_INIT_CONFIG_DEFAULT();
    ESP_ERROR_CHECK(esp_wifi_init(&cfg));

    wifi_config_t wifi_config = {};
    strncpy((char*)wifi_config.ap.ssid, WIFI_SSID, sizeof(wifi_config.ap.ssid) - 1);
    strncpy((char*)wifi_config.ap.password, WIFI_PASS, sizeof(wifi_config.ap.password) - 1);
    wifi_config.ap.ssid_len = strlen(WIFI_SSID);
    wifi_config.ap.max_connection = 4;
    wifi_config.ap.authmode = WIFI_AUTH_WPA_WPA2_PSK;

    ESP_ERROR_CHECK(esp_wifi_set_mode(WIFI_MODE_AP));
    ESP_ERROR_CHECK(esp_wifi_set_config(WIFI_IF_AP, &wifi_config));
    ESP_ERROR_CHECK(esp_wifi_start());

    ESP_LOGI(TAG, "Punt d'accés creat → SSID:%s  PASS:%s", WIFI_SSID, WIFI_PASS);
    ESP_LOGI(TAG, "IP per defecte: 192.168.4.1");
}

/* ---------- Sensor de distància HC-SR04 ---------- */
static float read_distance_cm()
{
    gpio_set_level(TRIG_PIN, 0);
    esp_rom_delay_us(2);
    gpio_set_level(TRIG_PIN, 1);
    esp_rom_delay_us(10);
    gpio_set_level(TRIG_PIN, 0);

    int64_t start_time = esp_timer_get_time();
    while (gpio_get_level(ECHO_PIN) == 0) {
        if (esp_timer_get_time() - start_time > 500000) return -1; // timeout 0.5s
    }

    int64_t echo_start = esp_timer_get_time();
    while (gpio_get_level(ECHO_PIN) == 1) {
        if (esp_timer_get_time() - echo_start > 500000) return -1;
    }
    int64_t echo_end = esp_timer_get_time();

    float pulse_duration_us = echo_end - echo_start;
    float distance_cm = (pulse_duration_us / 2.0f) / 29.1f; // velocitat del so 343 m/s
    return distance_cm;
}

/* ---------- UDP Send Task ---------- */
static void udp_send_task(void *arg)
{
    struct sockaddr_in dest_addr = {};
    dest_addr.sin_family = AF_INET;
    dest_addr.sin_port = htons(UDP_PORT);
    inet_pton(AF_INET, RECEIVER_IP, &dest_addr.sin_addr.s_addr);

    int sock = socket(AF_INET, SOCK_DGRAM, IPPROTO_IP);
    if (sock < 0) {
        ESP_LOGE(TAG, "Error creant socket UDP");
        vTaskDelete(NULL);
        return;
    }

    ESP_LOGI(TAG, "Enviant dades UDP a %s:%d", RECEIVER_IP, UDP_PORT);

    while (true) {
        float dist = read_distance_cm();
        char msg[64];
        if (dist > 0){
            int64_t now = esp_timer_get_time();
            snprintf(msg, sizeof(msg), "SEQ=%lu;DIST=%.1f",seq_esp, dist);
        }else{
            snprintf(msg, sizeof(msg), "Error de lectura sensor distància");
        }
        sendto(sock, msg, strlen(msg), 0, (struct sockaddr *)&dest_addr, sizeof(dest_addr));
        seq_esp++;
        tx_esp++;

        vTaskDelay(pdMS_TO_TICKS(20)); // 50Hz
    }

    close(sock);
    vTaskDelete(NULL);
}


// -----------------------------------------------------------------------------
// Tasca UDP per rebre dades i mostra el seu contingut per log.
// -----------------------------------------------------------------------------
static void udp_receive_task(void *arg)
{
    struct sockaddr_in server_addr, client_addr, reply_addr;
    socklen_t client_len = sizeof(client_addr);
    char rx_buffer[RECV_BUF_SIZE];

    int sock = socket(AF_INET, SOCK_DGRAM, IPPROTO_IP);
    if (sock < 0) {
        ESP_LOGE(TAG, "Error creant socket UDP");
        vTaskDelete(NULL);
        return;
    }

    server_addr.sin_addr.s_addr = INADDR_ANY;
    server_addr.sin_family = AF_INET;
    server_addr.sin_port = htons(UDP_PORT);

    if (bind(sock, (struct sockaddr *)&server_addr, sizeof(server_addr)) < 0) {
        ESP_LOGE(TAG, "Error en bind()");
        close(sock);
        vTaskDelete(NULL);
        return;
    }

    ESP_LOGI(TAG, "Escoltant UDP (rebent dades del comandament)...");

    while (1) {
        int len = recvfrom(sock, rx_buffer, sizeof(rx_buffer) - 1, 0,
                           (struct sockaddr *)&client_addr, &client_len);   //Recepció del paquet UDP

        if (len > 0) {
            rx_buffer[len] = 0;

            // ----------------------------------------------------
            // Extreure seq per comptar paquets
            // ----------------------------------------------------
            uint32_t seq = 0;   // Variables locals
            sscanf(rx_buffer, "SEQ=%lu", &seq); // Llegir SEQ del comandament

            // ----------------------------------------------------
            // Actualitzar estadístiques RX
            // ----------------------------------------------------
            update_rx_com(seq);
            float loss = loss_com_percent();

            // Parse joystick
            parse_vx_vy_from_msg(rx_buffer, &vx_value, &vy_value);

            // LOG
            ESP_LOGI(TAG,
                "Tx_ESP: SEQ_ESP=%lu TX_ESP=%lu",
                seq_esp,tx_esp);

            ESP_LOGI(TAG,
                "Rx_COM: SEQ_COM=%lu RX_COM=%lu LOST_COM=%lu LOSS_COM=%.2f%%",
                seq,rx_com,lost_com,loss);

            ESP_LOGI(TAG,
                "vx: %.1f   vy: %.1f   BTN=%d"
                ,vx_value,vy_value,btn_pressed);
        }

        vTaskDelay(pdMS_TO_TICKS(10));
    }

    close(sock);
    vTaskDelete(NULL);
}

/* ---------- Funció inicialització Servo ---------- */
static void init_servo()
{
    mcpwm_gpio_init(MCPWM_UNIT_0, MCPWM0A, SERVO_GPIO);

    mcpwm_config_t pwm_config;
    pwm_config.frequency = 50;         // 50 Hz
    pwm_config.cmpr_a = 0;             // duty inicial
    pwm_config.cmpr_b = 0;
    pwm_config.counter_mode = MCPWM_UP_COUNTER;
    pwm_config.duty_mode = MCPWM_DUTY_MODE_0;

    mcpwm_init(MCPWM_UNIT_0, MCPWM_TIMER_0, &pwm_config);

    ESP_LOGI(TAG, "Servo inicialitzat al pin %d", SERVO_GPIO);
}

// Converteix angle 0-180 a polsos µs
static uint32_t angle_to_us(float angle)
{
    return SERVO_MIN_US + (angle * (SERVO_MAX_US - SERVO_MIN_US) / 180);
}


/* ---------- Control del Servo tipus actuador hidràulic---------- */
static void servo_task(void *arg)
{
    while (1) {

        // Convertim joystick a velocitat incremental (-1 a +1)
        float speed = 0;
        float deadzone = 5.0; // graus centrals que es consideren "quiet"

        if (vx_value > 90 + deadzone) {
            speed = (vx_value - 90) / 90.0;  // cap a la dreta
        } else if (vx_value < 90 - deadzone) {
            speed = (vx_value - 90) / 90.0;  // cap a l'esquerra
        } else {
            speed = 0; // totalment quiet
        }

        // --- Mou només si botó premut i joystick fora zona morta ---
        if (btn_pressed && fabs(speed) > 0.05) {
            last_angle += speed * 2.0; // ajustable: velocitat del servo
            if (last_angle < 0) last_angle = 0;
            if (last_angle > 180) last_angle = 180;
        }

        // --- Aplica l’última posició --- 
        uint32_t pulse = angle_to_us(last_angle);

        mcpwm_set_duty_in_us(
            MCPWM_UNIT_0,
            MCPWM_TIMER_0,
            MCPWM_OPR_A,
            pulse
        );

        vTaskDelay(pdMS_TO_TICKS(20));
    }
}


/* ---------- app_main ---------- */
extern "C" void app_main()
{
    // Configuració dels pins del sensor distància HC-SR04
    gpio_config_t io_conf = {};
    io_conf.intr_type = GPIO_INTR_DISABLE;
    io_conf.mode = GPIO_MODE_OUTPUT;
    io_conf.pin_bit_mask = (1ULL << TRIG_PIN);
    io_conf.pull_down_en = GPIO_PULLDOWN_DISABLE;
    io_conf.pull_up_en = GPIO_PULLUP_DISABLE;
    gpio_config(&io_conf);

    io_conf.mode = GPIO_MODE_INPUT;
    io_conf.pin_bit_mask = (1ULL << ECHO_PIN);
    gpio_config(&io_conf);

    // Inicia Wi-Fi en mode punt d'accés
    init_wifi_ap();

    // Llança la tasca d'enviament UDP
    xTaskCreate(udp_send_task, "udp_send_task", 4096, NULL, 5, NULL);

    // Inicialitza el servo
    init_servo();

    // Tasques per receptor UDP i servo
    xTaskCreate(udp_receive_task, "udp_receive_task", 4096, NULL, 5, NULL);
    xTaskCreate(servo_task, "servo_task", 4096, NULL, 5, NULL);

}
