Aleixgelabert/TFM/HARDWARE/EXISTENT SKORPIOS/SOFTWARE/PLC Twincat/BIN/Parameters.txt

Engine - Parameters:
Engine_Min_RPM	750.0
Engine_Max_RPM	2500.0
Engine_Boost_RPM	2600.0
Engine_Stop_RPM	2600.0
Engine_MaxInc_RPM	2000.0
Engine_MaxDec_RPM	200.0
Engine_DlyDec_sec	10.0
Engine_HP_Nx_RPM	1200.0
Engine_HP_SF_RPM	800.0
Engine_LP_CK_RPM	2400.0
Engine_LP_1x_RPM	1400.0
Engine_LP_2x_RPM	1600.0
Engine_LP_3x_RPM	1900.0
Engine_LP_Nx_RPM	2300.0
Engine_N_WinchWOP	5
Engine_N_WinchWK	4
Engine_N_WinchWP	4
Engine_Max_Torque	85.0
Engine_Min_Torque	65.0
Engine_Inc_RMP_Perc_WOP	10.0
Engine_Dec_Flow_Perc_WP	30.0
Engine_Max_HeatExch_P	5.0
Engine_EnForceRPM	TRUE
Engine_EnForceTHR	FALSE
Powerpack - Parameters:
Powerpack_Hyst_HP	0.0
Powerpack_Hyst_LP	0.0
Powerpack_Hyst_TM	2.0
Powerpack_Thr_HP	4.5
Powerpack_Thr_LP	4.5
Propulsion - Parameters:
Propulsion_Thrt0_V	-4.09999990463257
Propulsion_Thrt4_V	-8.00000011920929e-1
Propulsion_Thrt5_V	0.0
Propulsion_Thrt6_V	8.00000011920929e-1
Propulsion_Thrt10_V	4.09999990463257
Propulsion_ThrDB_V	6.99999988079071e-1
Propulsion_RPM_K	40.0
Propulsion_Delay_Off	2.0
Propulsion_RPM0	2300.0
Propulsion_RPM1	2050.0
Propulsion_RPM2	1850.0
Propulsion_RPM3	1650.0
Propulsion_RPM4	1450.0
Propulsion_RPM5	0.0
Propulsion_RPM6	1400.0
Propulsion_RPM7	1650.0
Propulsion_RPM8	1850.0
Propulsion_RPM9	2050.0
Propulsion_RPM10	2300.0
Propulsion_EVP0_mA	480.0
Propulsion_EVP1_mA	450.0
Propulsion_EVP2_mA	420.0
Propulsion_EVP3_mA	390.0
Propulsion_EVP4_mA	340.0
Propulsion_EVP5_mA	0.0
Propulsion_EVP6_mA	340.0
Propulsion_EVP7_mA	450.0
Propulsion_EVP8_mA	500.0
Propulsion_EVP9_mA	550.0
Propulsion_EVP10_mA	580.0
A3Tack - Parameters:
A3Tack_Ease	0.0
A3Tack_TgtLS_In	3.0
A3Tack_TgtLS_Out	97.0
A3Tack_TgtLS_Slow	50.0
A3Tack_TimeMax	0.0
A3Tack_TimeEase	0.0
A3Tack_LS_Limit_In	TRUE
A3Tack_LS_Limit_Out	TRUE
A3Tack_HP	2
FrTack - Parameters:
FrTack_Ease	0.0
FrTack_TgtLS_In	3.0
FrTack_TgtLS_Out	97.0
FrTack_TgtLS_Slow	50.0
FrTack_TimeMax	0.0
FrTack_TimeEase	0.0
FrTack_LS_Limit_In	TRUE
FrTack_LS_Limit_Out	TRUE
FrTack_HP	2
J5 - Parameters:
J5_Ease	0.0
J5_TgtLS_In	3.0
J5_TgtLS_Out	97.0
J5_TgtLS_Slow	0.0
J5_TimeMax	0.0
J5_TimeEase	2.0
J5_LS_Limit_In	TRUE
J5_LS_Limit_Out	TRUE
J5_HP	1
J4 - Parameters:
J4_Ease	0.0
J4_TgtLS_In	3.0
J4_TgtLS_Out	97.0
J4_TgtLS_Slow	0.0
J4_TimeMax	0.0
J4_TimeEase	2.0
J4_LS_Limit_In	TRUE
J4_LS_Limit_Out	TRUE
J4_HP	1
Fsy - Parameters:
Fsy_Ease	0.0
Fsy_TgtLS_In	3.0
Fsy_TgtLS_Out	97.0
Fsy_TgtLS_Slow	0.0
Fsy_TimeMax	0.0
Fsy_TimeEase	2.0
Fsy_LS_Limit_In	TRUE
Fsy_LS_Limit_Out	TRUE
Fsy_HP	1
J2 - Parameters:
J2_Ease	0.0
J2_TgtLS_In	3.0
J2_TgtLS_Out	97.0
J2_TgtLS_Slow	0.0
J2_TimeMax	0.0
J2_TimeEase	0.0
J2_LS_Limit_In	TRUE
J2_LS_Limit_Out	TRUE
J2_HP	1
JibIO - Parameters:
JibIO_Ease	0.0
JibIO_TimeMax	0.0
JibIO_TimeEase	0.0
JibIO_HP	1
JibUD - Parameters:
JibUD_Ease	0.0
JibUD_TimeMax	0.0
JibUD_TimeEase	0.0
JibUD_HP	1
Vang - Parameters:
Vang_Ease	0.0
Vang_TimeMax	0.0
Vang_TimeEase	0.0
Vang_HP	1
PropUpDw - Parameters:
PropUpDw_TgtP_Up	150.0
PropUpDw_TgtP_Dw	120.0
PropUpDw_TgtLS_Up	1.0
PropUpDw_TgtLS_Dw	99.0
PropUpDw_P_DB	50.0
PropUpDw_LS_DB	5.0e-1
PropUpDw_TimeMax	0.0
PropUpDw_Delay_Up	5.0e-1
PropUpDw_Delay_Dw	5.0e-1
PropUpDw_HP_Up	1
PropUpDw_HP_Dw	2
TrimTab - Parameters:
TrimTab_TgtLS_In	5.0
TrimTab_TgtLS_Out	95.0
TrimTab_TgtLS_Mid	50.0
TrimTab_TgtLS_DB	2.0
TrimTab_TimeMax	0.0
TrimTab_LS_Limit_In	TRUE
TrimTab_LS_Limit_Out	TRUE
TrimTab_HP	1
Inn - Parameters:
Inn_Ease	0.0
Inn_TimeMax	0.0
Inn_TimeEase	0.0
Inn_HP	1
Out - Parameters:
Out_Ease	0.0
Out_TimeMax	0.0
Out_TimeEase	0.0
Out_HP	1
Cunn - Parameters:
Cunn_Ease	0.0
Cunn_TimeMax	0.0
Cunn_TimeEase	0.0
Cunn_HP	1
Runn - Parameters:
Runn_Ease	0.0
Runn_TgtLS_In	5.0
Runn_TgtLS_Out	97.0
Runn_TgtLS_Slow	0.0
Runn_TimeMax	0.0
Runn_TimeEase	0.0
Runn_LS_Limit_In	TRUE
Runn_LS_Limit_Out	TRUE
Runn_HP	1
Chksy - Parameters:
Chksy_Ease	0.0
Chksy_TgtLS_In	5.0
Chksy_TgtLS_Out	97.0
Chksy_TgtLS_Slow	0.0
Chksy_TimeMax	0.0
Chksy_TimeEase	0.0
Chksy_LS_Limit_In	TRUE
Chksy_LS_Limit_Out	TRUE
Chksy_HP	1
BsyP - Parameters:
BsyP_Ease	200.0
BsyP_TgtLS_In	3.0
BsyP_TgtLS_Out	97.0
BsyP_TgtLS_Slow	0.0
BsyP_TimeMax	0.0
BsyP_TimeEase	2.0
BsyP_LS_Limit_In	FALSE
BsyP_LS_Limit_Out	FALSE
BsyP_HP	1
WB - Parameters:
WB_TimeMax_Idle	15.0
WB_TimeMax_Init	30.0
WB_TimeMax_DumpFwd	25.0
WB_TimeMax_DumpAft	15.0
WB_TimeMax_MoveFwd	30.0
WB_TimeMax_MoveAft	25.0
WB_EVP_Pump_Min	5.0
WB_EVP_Pump_Max	70.0
WB_EVP_Pump_Inc	25.0
WB_EVP_Pump_Dec	25.0
WB_LP	2
WB_EnScoopAF	TRUE
WBValves - Parameters:
WBValves_TimeMax	0.0
WBValves_PushTime	0.0
WBValves_PushPress	40.0
WBValves_HP	1
WBValvesLS - Parameters:
WBValvesLS_TimeMax	0.0
WBValvesLS_PushTime	0.0
WBValvesLS_PushPress	70.0
WBValvesLS_TgtLS_Half	50.0
WBValvesLS_LS_DB	5.0
WBValvesLS_HP	1
W1202 - Parameters:
W1202_Spd11	30.0
W1202_Spd21	30.0
W1202_Spd17	100.0
W1202_Spd27	60.0
W1202_P1_Max	260.0
W1202_P2_Max	320.0
W1202_P3_Max	320.0
W1202_A_Spd1	TRUE
W1202_TimeMax	0.0
W1204 - Parameters:
W1204_Spd11	30.0
W1204_Spd21	30.0
W1204_Spd17	80.0
W1204_Spd27	60.0
W1204_P1_Max	200.0
W1204_P2_Max	200.0
W1204_P3_Max	0.0
W1204_A_Spd1	FALSE
W1204_TimeMax	0.0
W1206 - Parameters:
W1206_Spd11	30.0
W1206_Spd21	30.0
W1206_Spd17	50.0
W1206_Spd27	50.0
W1206_P1_Max	270.0
W1206_P2_Max	320.0
W1206_P3_Max	320.0
W1206_A_Spd1	TRUE
W1206_TimeMax	0.0
W1208 - Parameters:
W1208_Spd11	30.0
W1208_Spd21	30.0
W1208_Spd17	70.0
W1208_Spd27	40.0
W1208_P1_Max	260.0
W1208_P2_Max	300.0
W1208_P3_Max	320.0
W1208_A_Spd1	TRUE
W1208_TimeMax	0.0
W1210 - Parameters:
W1210_Spd11	30.0
W1210_Spd21	30.0
W1210_Spd17	100.0
W1210_Spd27	60.0
W1210_P1_Max	260.0
W1210_P2_Max	320.0
W1210_P3_Max	320.0
W1210_A_Spd1	TRUE
W1210_TimeMax	0.0
W1212 - Parameters:
W1212_Spd11	30.0
W1212_Spd21	30.0
W1212_Spd17	100.0
W1212_Spd27	60.0
W1212_P1_Max	260.0
W1212_P2_Max	320.0
W1212_P3_Max	320.0
W1212_A_Spd1	TRUE
W1212_TimeMax	0.0
W1214 - Parameters:
W1214_Spd11	30.0
W1214_Spd21	30.0
W1214_Spd17	80.0
W1214_Spd27	60.0
W1214_P1_Max	200.0
W1214_P2_Max	200.0
W1214_P3_Max	0.0
W1214_A_Spd1	FALSE
W1214_TimeMax	0.0
W1602 - Parameters:
W1602_Spd11	30.0
W1602_Spd21	30.0
W1602_Spd17	70.0
W1602_Spd27	50.0
W1602_P1_Max	260.0
W1602_P2_Max	300.0
W1602_P3_Max	320.0
W1602_A_Spd1	TRUE
W1602_TimeMax	0.0
W1604 - Parameters:
W1604_Spd11	30.0
W1604_Spd21	30.0
W1604_Spd17	100.0
W1604_Spd27	60.0
W1604_P1_Max	260.0
W1604_P2_Max	320.0
W1604_P3_Max	320.0
W1604_A_Spd1	FALSE
W1604_TimeMax	0.0
WRAMP_Min	5.0
WRAMP_Inc	40.0
WRAMP_Dec	180.0
Board - Parameters:
Board_TgtLS_P_In	91.8000030517578
Board_TgtLS_P_InR	79.6999969482422
Board_TgtLS_P_Out	4.40000009536743
Board_TgtLS_P_OutR	17.5
Board_TgtLS_P_Mid	48.2999992370606
Board_TgtLS_S_In	91.1999969482422
Board_TgtLS_S_InR	79.0999984741211
Board_TgtLS_S_Out	4.0
Board_TgtLS_S_OutR	17.0
Board_TgtLS_S_Mid	48.5
Board_TgtLS_P_Safe_In	62.7999992370606
Board_TgtLS_P_Safe_Out	33.2000007629395
Board_TgtLS_S_Safe_In	62.5
Board_TgtLS_S_Safe_Out	33.0
Board_LS_Dif_Tgt	0.0
Board_LS_Dif_Max	1.0
Board_LS_Dif_Min	1.0
Board_LS_DB	1.5
Board_P_Hyst_HP	-5.0
Board_P_Hyst_LP	-5.0
Board_P_Hyst_TM	0.0
Board_Keel_P_Max	68.0
Board_Keel_S_Min	38.0
Board_EVP_In_P_Min	10.0
Board_EVP_In_P_Max	100.0
Board_EVP_In_S_Min	11.0
Board_EVP_In_S_Max	100.0
Board_EVP_Out_P_Min	4.0
Board_EVP_Out_P_Max	100.0
Board_EVP_Out_S_Min	11.0
Board_EVP_Out_S_Max	100.0
Board_EVP_In_P_Eng	55.0
Board_EVP_In_P_PP	14.0
Board_EVP_In_S_Eng	55.0
Board_EVP_In_S_PP	15.0
Board_EVP_Out_P_Eng	12.0
Board_EVP_Out_P_PP	12.0
Board_EVP_Out_S_Eng	20.0
Board_EVP_Out_S_PP	20.0
Board_EVP_In_EVP_K	0.0
Board_EVP_Out_EVP_K	12.0
Board_EVP_In_LS_K	7.0
Board_EVP_Out_LS_K	2.0
Board_EVP_In_Inc	45.0
Board_EVP_Out_Inc	3.0
Board_EVP_In_Dec	20.0
Board_EVP_Out_Dec	20.0
Board_LP	2
Board_TimeMax	0.0
Keel - Parameters:
Keel_TgtLS_In	1.0
Keel_TgtLS_Mid	53.5999984741211
Keel_TgtLS_Out	99.0
Keel_TgtLS_Safe_In	27.0499992370606
Keel_TgtLS_Safe_Out	76.6500015258789
Keel_TgtLS_Tack_Off	-3.0
Keel_LS_DB	1.0
Keel_Board_P_Min_Out	22.5
Keel_Board_S_Min_Out	22.0
Keel_EVP_In_SE_Min	250.0
Keel_EVP_In_SE_Max	700.0
Keel_EVP_In_SE_Man	400.0
Keel_EVP_In_FE_Min	250.0
Keel_EVP_In_FE_Max	700.0
Keel_EVP_In_FE_Man	400.0
Keel_EVP_In_Eng_Min	270.0
Keel_EVP_In_Eng_Max	420.0
Keel_EVP_In_Eng_Man	330.0
Keel_EVP_In_P_Empty	40.0
Keel_EVP_Out_SE_Min	250.0
Keel_EVP_Out_SE_Max	700.0
Keel_EVP_Out_SE_Man	400.0
Keel_EVP_Out_SE_Empty	700.0
Keel_EVP_Out_FE_Min	250.0
Keel_EVP_Out_FE_Max	700.0
Keel_EVP_Out_FE_Man	400.0
Keel_EVP_Out_Eng_Min	270.0
Keel_EVP_Out_Eng_Max	455.0
Keel_EVP_Out_Eng_Man	360.0
Keel_EVP_Out_Fill_Min	20.0
Keel_EVP_Out_Fill_Max	45.0
Keel_EVP_Out_P_Fill	40.0
Keel_EVP_In_SE_Inc	250.0
Keel_EVP_In_SE_Dec	250.0
Keel_EVP_In_FE_Inc	400.0
Keel_EVP_In_FE_Dec	400.0
Keel_EVP_Out_SE_Inc	250.0
Keel_EVP_Out_SE_Dec	250.0
Keel_EVP_Out_FE_Inc	400.0
Keel_EVP_Out_FE_Dec	400.0
Keel_EVP_In_Eng_Inc	115.0
Keel_EVP_In_Eng_Dec	135.0
Keel_EVP_Out_Eng_Inc	125.0
Keel_EVP_Out_Eng_Dec	145.0
Keel_EVP_In_Eng_K	50.0
Keel_EVP_Out_Eng_K	60.0
Keel_LP	2
Keel_TimeMax	0.0
Traveller - Parameters:
Traveller_MaxEVPA	25.0
Traveller_MaxEVPB	25.0
Traveller_MinEVPA	10.0
Traveller_MinEVPB	10.0
Traveller_Spd_Inc	0.0
Traveller_Spd_Dec	0.0
Traveller_TgtLS_Max	100.0
Traveller_TgtLS_Zero	50.0
Traveller_TgtLS_Min	5.0e-1
Traveller_TgtLS_Tack_Off	2.0
Traveller_LS_DB	1.5
Traveller_LS_Dist	5.0
Traveller_LS_Limit	TRUE
Traveller_TimeMax	0.0
Traveller_Hyst_HP	340.0
Traveller_Hyst_LP	320.0
Traveller_Hyst_TM	2.0
Traveller_HP	2
Traveller_LP	1
BowThr - Parameters:
BowThr_SpdA_Min	30.0
BowThr_SpdA_Max	85.0
BowThr_SpdB_Min	30.0
BowThr_SpdB_Max	85.0
BowThr_Spd_Inc	70.0
BowThr_Spd_Dec	70.0
BowThr_SF1_Limit	FALSE
BowThr_SF2_Limit	FALSE
BowThr_A_Spd1	TRUE
BowThr_TimeMax	0.0
BowThrUpDw - Parameters:
BowThrUpDw_SpdA_Min	50.0
BowThrUpDw_SpdA_Max	50.0
BowThrUpDw_SpdB_Min	50.0
BowThrUpDw_SpdB_Max	50.0
BowThrUpDw_Spd_Inc	0.0
BowThrUpDw_Spd_Dec	0.0
BowThrUpDw_SF1_Limit	TRUE
BowThrUpDw_SF2_Limit	TRUE
BowThrUpDw_A_Spd1	FALSE
BowThrUpDw_TimeMax	0.0
TackValve - Parameters:
TackValve_TimeMax	10.0
TackValve_Hyst_HeelH	28.0
TackValve_Hyst_HeelL	20.0
TackValve_Hyst_Time	3.0

#UDP Parameters:
UDPHost	192.168.10.10
UDPPort	50107
UDPTime	100

UDPRecvPort	50007
UDPAlarmsHost	
UDPAlarmsPort	0
