Aleixgelabert/TFM/SOFTWARE/CORE/COMANDAMENT_V4/components/lvgl_ui/tileview/system_tile.cpp

#include "system_tile.h"                          // Inclou el fitxer de capçalera propi d’aquest mòdul
#include "freertos/FreeRTOS.h"                    // Biblioteca base de FreeRTOS
#include "freertos/task.h"                        // Per crear i gestionar tasques
#include "freertos/semphr.h"                      // Per utilitzar semàfors
#include "esp_flash.h"                            // Per obtenir informació sobre la memòria flash
#include "esp_private/esp_clk.h"                  // Per llegir la freqüència de la CPU
#include "esp_pcf85063_port.h"                    // Control del rellotge RTC extern
#include "esp_3inch5_lcd_port.h"                  // Controlador per a la pantalla LCD 3.5”
#include "esp_axp2101_port.h"                     // Controlador ax2101
#include "esp_wifi.h"
#include "esp_netif.h"
#include <stdbool.h>
#include "battery_0.h"
#include "battery_25.h"
#include "battery_50.h"
#include "battery_75.h"
#include "battery_100.h"
#include "battery_charging.h"
#include "wifi_off.h"
#include "wifi_1.h"
#include "wifi_2.h"
#include "wifi_3.h"
#include "pmu_battery.h"

// Declaració de les icones de Wi-Fi i Bateria
LV_IMG_DECLARE(battery_0);
LV_IMG_DECLARE(battery_25);
LV_IMG_DECLARE(battery_50);
LV_IMG_DECLARE(battery_75);
LV_IMG_DECLARE(battery_100);
LV_IMG_DECLARE(battery_charging);

LV_IMG_DECLARE(wifi_off);
LV_IMG_DECLARE(wifi_1);
LV_IMG_DECLARE(wifi_2);
LV_IMG_DECLARE(wifi_3);

// Variables globals per etiquetes de la interfície gràfica (LVGL)
lv_obj_t *label_sensor_position = NULL;
lv_obj_t *label_joystick_position_X = NULL;
lv_obj_t *label_output_joystick_X = NULL;
lv_obj_t *label_servo_angle = NULL;
lv_obj_t *icon_battery = NULL;
lv_obj_t *icon_wifi = NULL;
lv_obj_t *label_batt_pct = NULL;
lv_obj_t *label_estop = NULL;
lv_obj_t *label_confirm = NULL;


void system_set_estop(bool estop_active)
{
    if (label_estop)
    {
        lv_label_set_text(label_estop, estop_active ? "ON" : "OFF");
        lv_obj_set_style_text_color(label_estop,
                                    estop_active ? lv_color_hex(0xEF4444) : lv_color_hex(0x000000),
                                    LV_PART_MAIN);
    }
}

void system_set_confirm(bool pressed)
{
    if (label_confirm)
    {
        if (pressed)
            lv_label_set_text(label_confirm, "ON");
        else
            lv_label_set_text(label_confirm, "OFF");
    }
}

void system_set_joystick_vx(int vx)
{
    if (label_output_joystick_X)
        lv_label_set_text_fmt(label_output_joystick_X , "%d mV", vx);
}

void system_set_joystick_vx_pct(int Vx_pct)
{
    if (label_joystick_position_X)
        lv_label_set_text_fmt(label_joystick_position_X , "%d %%", Vx_pct);
}

void system_set_servo_angle(int angle)
{
    if (label_servo_angle)
        lv_label_set_text_fmt(label_servo_angle, "%d deg", angle);
}


//---------------------------------------------------------
// Inicialització del sistema i lectura de recursos de maquinari
//---------------------------------------------------------
void system_init(void)
{
 // Aquí es pot inicialitzar sensors, PMU, RTC si cal
}


//---------------------------------------------------------
// Inicialitza tota la interfície gràfica del “System”
//---------------------------------------------------------
void system_tile_init(lv_obj_t *parent)
{
    lv_obj_t *list = lv_list_create(parent);                         // Crea una llista de paràmetres
    lv_obj_t *label = lv_label_create(parent);                       // Crea el títol superior
    lv_obj_set_style_text_font(label, &lv_font_montserrat_20, LV_PART_MAIN);    // Defineix la font del text de l’etiqueta com lv_font_montserrat_20, una mida de lletra mitjana/gran.                                                                               // LV_PART_MAIN indica que el canvi s’aplica a la part principal de l’objecte.
    lv_label_set_text(label, "TRIM TAB");
    lv_obj_align(label, LV_ALIGN_TOP_MID, 0, 10);        // Col·loca el títol a la part superior i centrada horitzontalment (TOP_MID),
                                                        // amb un petit desplaçament vertical de 10 píxels.
    lv_obj_set_size(list, lv_pct(95), lv_pct(73));      // Dona a la llista una mida del 95% de l’amplada i 73% de l’alçada del contenidor pare (parent).
                                                        // Així ocupa gairebé tota la pantalla.
    lv_obj_align(list, LV_ALIGN_TOP_MID, 0, 40);        // Col·loca la llista sota el títol, centrada a dalt, i amb 40 píxels de marge des del top.


    // Elements de la llista amb diferents informacions del sistema
    lv_obj_t *list_item;

    list_item = lv_list_add_btn(list, NULL, "E-STOP");
    label_estop = lv_label_create(list_item);
    lv_label_set_text(label_estop, "---");

    list_item = lv_list_add_btn(list, NULL, "CONFIRM");
    label_confirm = lv_label_create(list_item);
    lv_label_set_text(label_confirm, "---");

    list_item = lv_list_add_btn(list, NULL, "Distance");
    label_sensor_position = lv_label_create(list_item);
    lv_label_set_text(label_sensor_position, "--- cm");

    list_item = lv_list_add_btn(list, NULL, "Output Joystick X");
    label_output_joystick_X = lv_label_create(list_item);
    lv_label_set_text(label_output_joystick_X, "--- mV");

    list_item = lv_list_add_btn(list, NULL, "Position Joystick X");
    label_joystick_position_X = lv_label_create(list_item);
    lv_label_set_text(label_joystick_position_X, "--- %");

    list_item = lv_list_add_btn(list, NULL, "Servo Angle");
    label_servo_angle = lv_label_create(list_item);
    lv_label_set_text(label_servo_angle, "--- deg");

    system_init();                                     // Inicialitza el maquinari

    
    // Icona bateria
    icon_battery = lv_img_create(parent);
    lv_obj_align(icon_battery, LV_ALIGN_TOP_RIGHT, -17, -10);

    // Percentatge de bateria
    label_batt_pct = lv_label_create(parent);
    lv_label_set_text(label_batt_pct, "");
    lv_obj_align(label_batt_pct, LV_ALIGN_TOP_RIGHT, -10, 12);
    lv_obj_set_style_text_font(label_batt_pct, &lv_font_montserrat_12, 0);

    // -------- CANVI: Actualitzar el label amb valor real de bateria si hi ha dades --------
    int pct = pmu_get_battery_percentage();
    bool chg = pmu_is_charging();
    system_update_battery(pct, chg);


    // Icona WiFi
    icon_wifi = lv_img_create(parent);
    lv_obj_align(icon_wifi, LV_ALIGN_TOP_RIGHT, -50, -10);

    lv_timer_create([](lv_timer_t *t){
    int pct = pmu_get_battery_percentage();
    bool chg = pmu_is_charging();

    system_update_battery(pct, chg);
    system_update_wifi(system_get_wifi_level());

    }, 2000, NULL);

}


// Actualitzar icona bateria segons percentatge i estat
void system_update_battery(int pct, bool charging)
{
    const lv_img_dsc_t *img;

    if (charging)
        img = &battery_charging;
    else if (pct > 80)
        img = &battery_100;
    else if (pct > 60)
        img = &battery_75;
    else if (pct > 40)
        img = &battery_50;
    else if (pct > 20)
        img = &battery_25;
    else
        img = &battery_0;

    //lv_img_set_src(icon_battery, img);
    if (icon_battery)
    {
    lv_img_set_src(icon_battery, img);
    lv_img_set_zoom(icon_battery, 128);  // Escalar la imatge a 50% de la mida original
    }

    // Actualitza el % al widget
    char buff[8];
    snprintf(buff, sizeof(buff), "%d%%", pct);
    //lv_label_set_text(label_batt_pct, buff);
    if (label_batt_pct)
    {
    lv_label_set_text(label_batt_pct, buff);

    // ---- Color del text ----
    if (charging)
    {
        lv_obj_set_style_text_color(label_batt_pct, lv_color_hex(0x3B82F6), 0);  // Blau
    }
    else if (pct > 50)
    {
        lv_obj_set_style_text_color(label_batt_pct, lv_color_hex(0x22C55E), 0);  // Verd
    }
    else if (pct > 20)
    {
        lv_obj_set_style_text_color(label_batt_pct, lv_color_hex(0xEAB308), 0);  // Groc
    }
    else
    {
        lv_obj_set_style_text_color(label_batt_pct, lv_color_hex(0xEF4444), 0);  // Vermell
    }
    }
}


// Actualitzar icona Wi-Fi segons RSSI:
void system_update_wifi(int level)
{
    if (!icon_wifi) return;

    switch(level)
    {
        case 3: lv_img_set_src(icon_wifi, &wifi_3); break;
        case 2: lv_img_set_src(icon_wifi, &wifi_2); break;
        case 1: lv_img_set_src(icon_wifi, &wifi_1); break;
        default:
            lv_img_set_src(icon_wifi, &wifi_off);
            break;
    }
        /* Escalar la icona Wi-Fi */
    lv_img_set_zoom(icon_wifi, 128);  // Ajusta la mida de la icona
}


// Lector RSSI ---> Nivell Wi-Fi
int system_get_wifi_level()
{
    wifi_ap_record_t info;

    if (esp_wifi_sta_get_ap_info(&info) != ESP_OK)
        return 0;

    int rssi = info.rssi;
    printf("RSSI actual: %d\n", rssi); // Afegeix això per veure el número real
    
    if (rssi > -60) return 3;
    if (rssi > -75) return 2;
    if (rssi > -85) return 1;
    return 0;
}
