Aleixgelabert/TFM/(commit log)

2025-11-30 Estructura carpetes bàsiques
    [3.5inch_48pin_QD3503.PcbLib, 3.5inch_48pin_QD3503.SchLib, ESP32-S3-Touch-LCD-3.5-C.dwg, ESP32-S3-Touch-LCD-3.5.dwg, Parameters.txt, TE-F33B-1-11X.igs, TE-F33B-1-11X.stp, TE-F33B-1-21X.igs]
2025-11-30 Pujar arxius V4
    [partitions.csv]
2025-11-30 Delete SOFTWARE/CORE/COMANDAMENT_V4 directory
    Versió pujada incorrecte
    [partitions.csv]
2025-11-30 Delete SOFTWARE/FEATURES_V4/SERVO directory
    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
2025-11-30 Pujar arxius featureV4
    [partitions.csv]
2025-11-30 Organització ESP32
    Creació de la carpeta SEGON_ESP32 per posar-hi els codis que es fan servir per conectar i provar el codi del comandament
2026-03-20 Actualització carpeta HARDWARE
    [10-855.stp, 10-856.stp, 3d model_61-6441.4047.stp, 68b.stp, AV044746A240k.stp, AV0630C9XX.stp, AV24LP404.stp, AV9SLD9xxx002.stp]
2026-03-20 Canvi ESP-IDF a v5.5.3
    [Prova.kicad_pcb, Prova.kicad_sch]
2026-03-20 Afegir arxiu 3D suport waveshare
    [Suport waveshare.3mf, Suport waveshare.f3d]
2026-03-22 Allargar potes suport 1mm
    [Suport waveshare.3mf]
2026-03-23 Millorres joystick
2026-03-25 Carpeta SEGON ESP32 moguda de lloc
2026-04-09 Segon ESP32 i Joystick Arduino
    [Funda_Joystick.3mf]
2026-04-09 Servo funcionant com hidràulic
2026-04-10 Creació E-stop
    [68b.stp, kh147cazssg22n01xx02.stp, kh246fazdeg22n01xx02.stp]
2026-04-12 Logs ESP32
2026-05-09 Canvi Print RSSI
2026-05-10 Visualització angle servo a pantalla
2026-05-25 Correcció Diagrama Model de simulació
