Aleixgelabert/TFM/(notices)

Notices in the files:
HARDWARE/SCREENS/ILI9488/LAFVIN/3.5inch_SPI_Module_ILI9488_MSP3520_V1.1/1-Demo/Demo_STM32/Demo_STM32F429IGT6_Hardware_SPI/HARDWARE/SPI/SPI.c:
Copyright(C) ÉîÛÚÊÐÈ«¶¯µç×Ó¼¼ÊõÓÐÏÞ¹«Ë¾ 2018-2028
All rights reserved
